liorknafo/plastic-shredder/cad/png/blade_variants.png

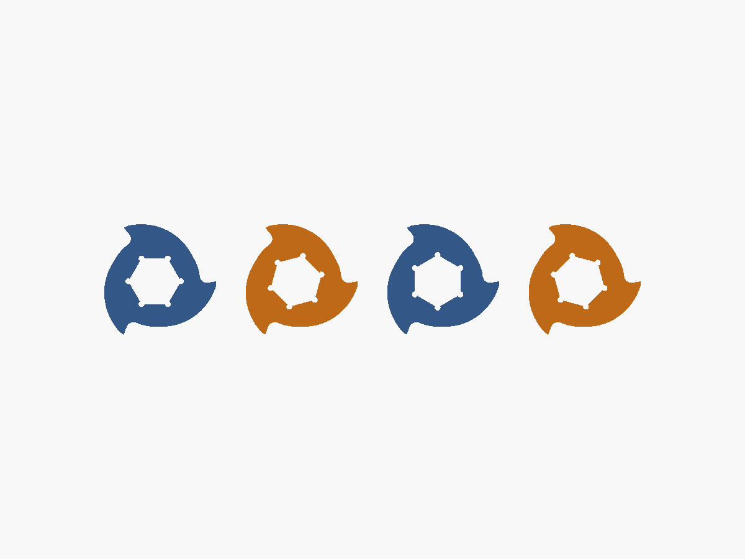
cad/png/blade_variants.png
