liorknafo/plastic-shredder/cad/png/comb_B.png

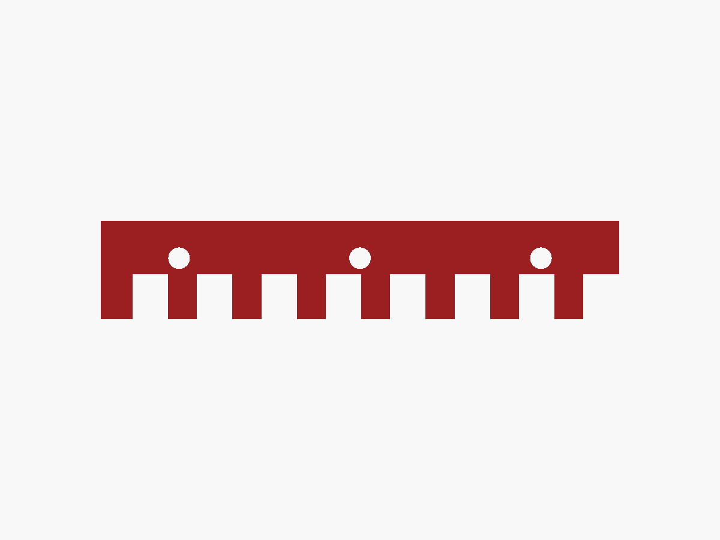
cad/png/comb_B.png
