liorknafo/plastic-shredder/cad/png/drive_tl.png

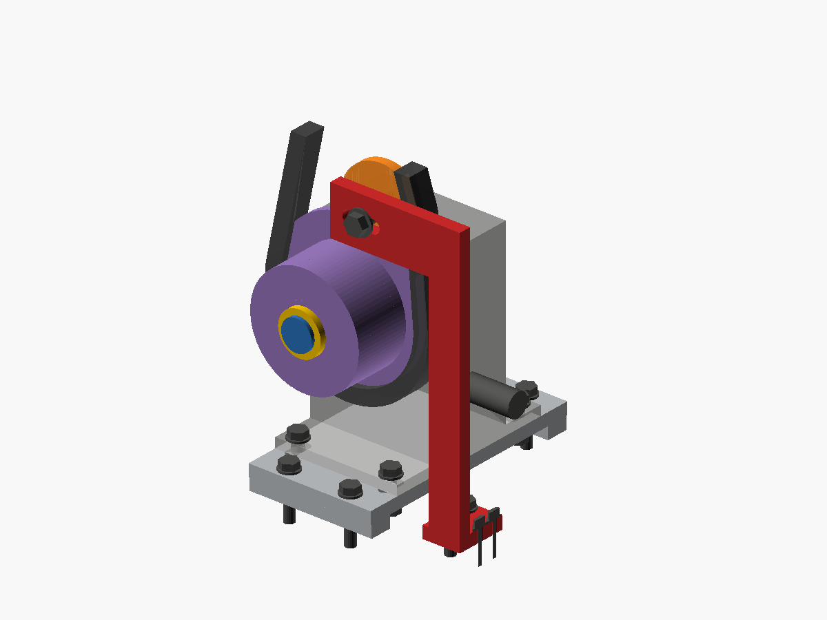
cad/png/drive_tl.png
