liorknafo/plastic-shredder/cad/png/drive_tl_section.png

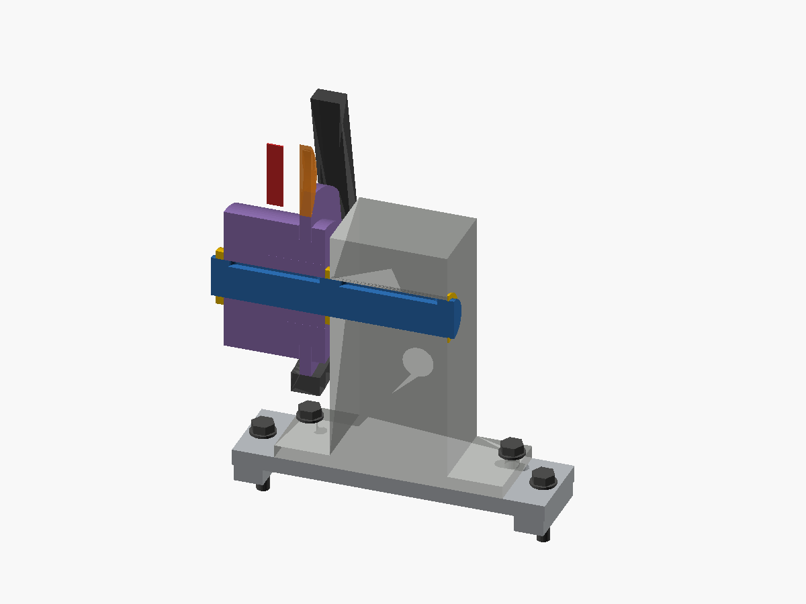
cad/png/drive_tl_section.png
