liorknafo/plastic-shredder/cad/png/gear_layer.png

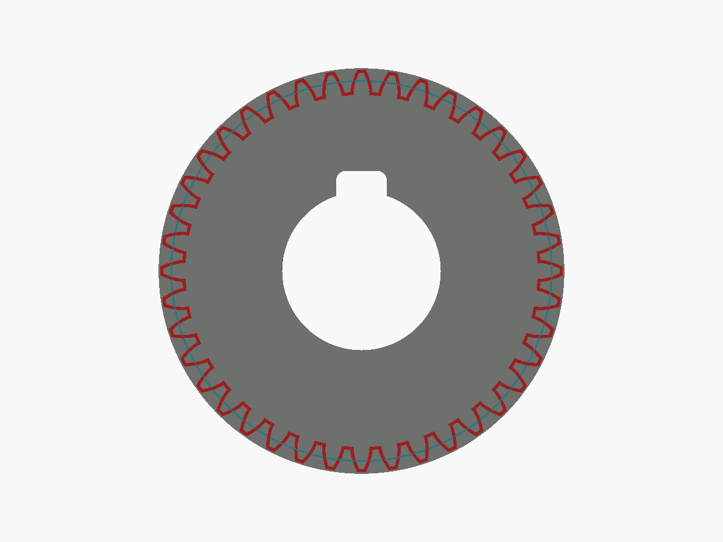
cad/png/gear_layer.png
