liorknafo/plastic-shredder/cad/png/gears_mesh.png

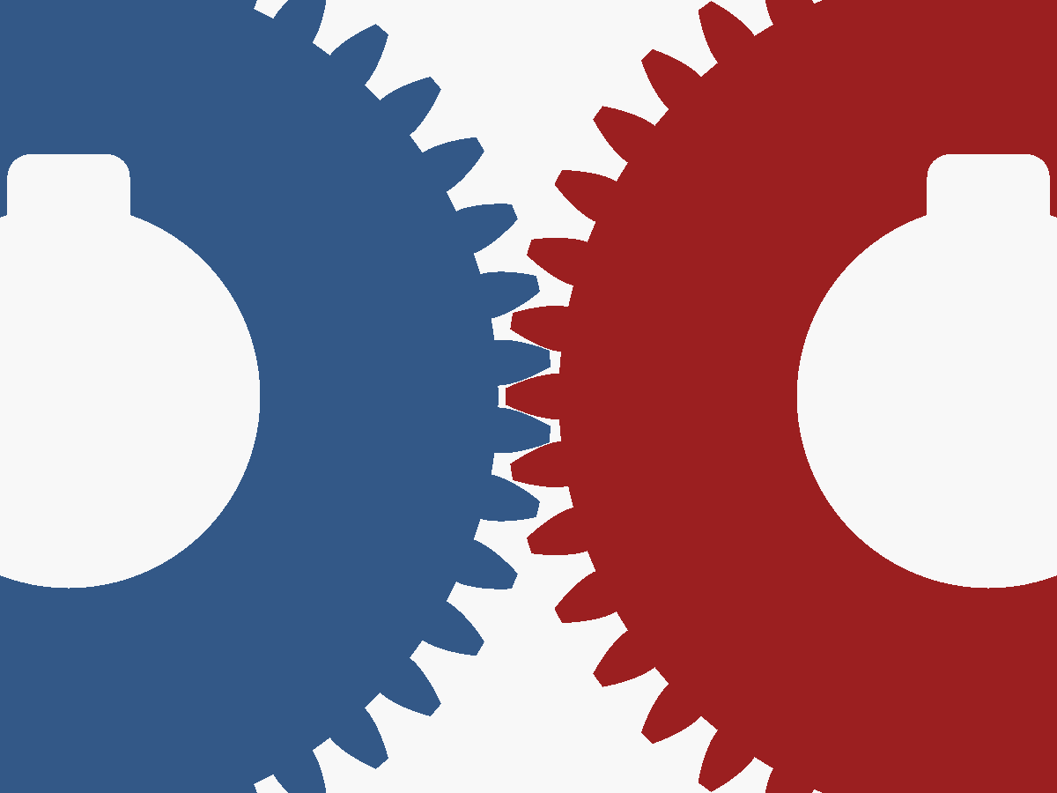
cad/png/gears_mesh.png
