liorknafo/plastic-shredder/cad/png/grid_section.png

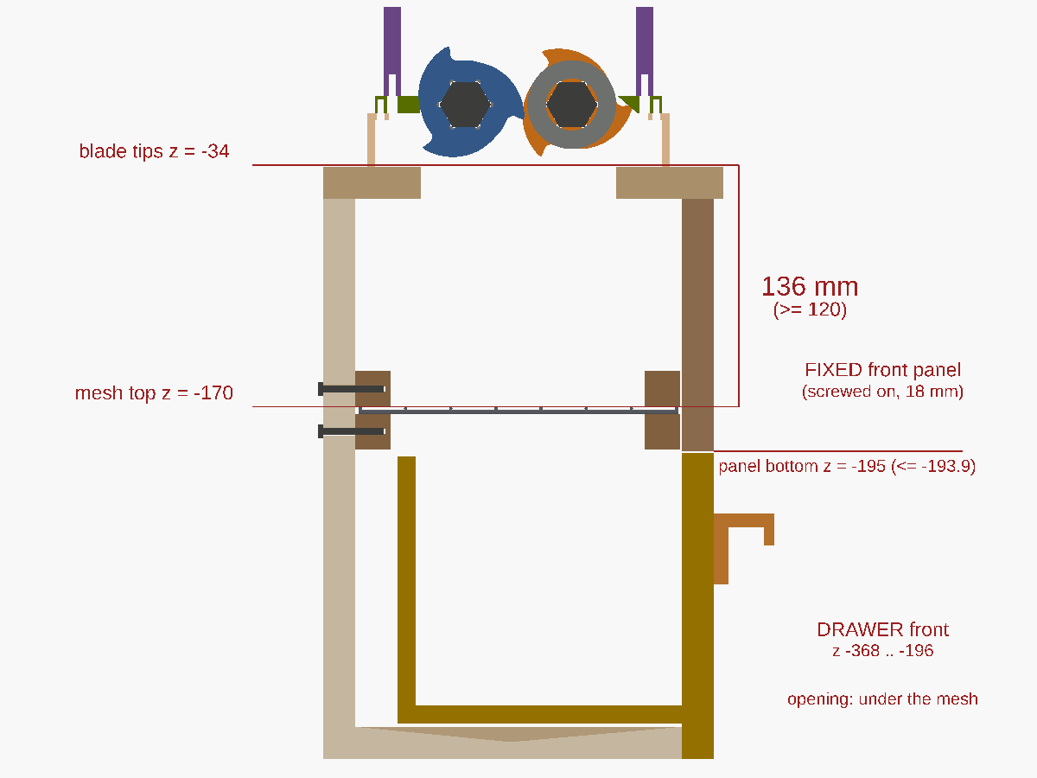
cad/png/grid_section.png
