liorknafo/plastic-shredder/cad/png/hopper_section.png

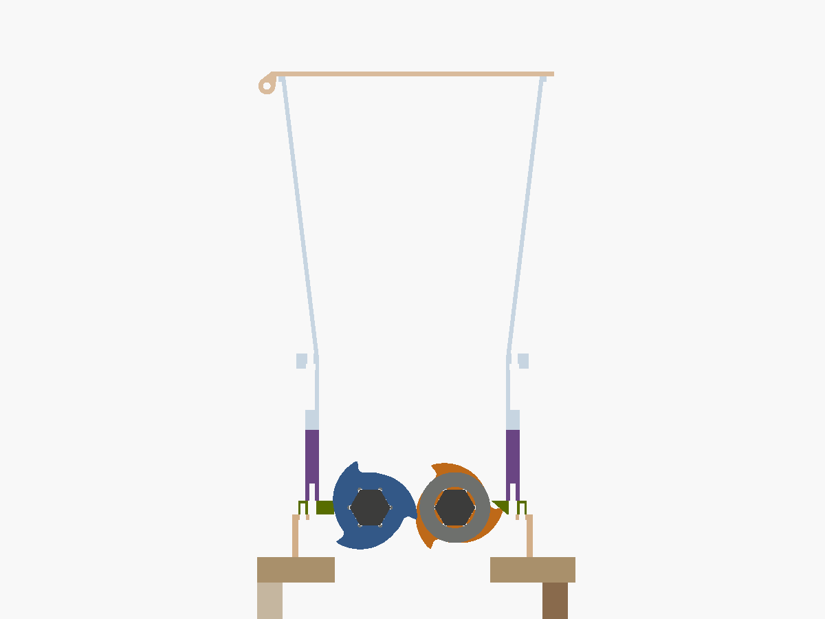
cad/png/hopper_section.png
