liorknafo/plastic-shredder/cad/png/interlock_drawer.png

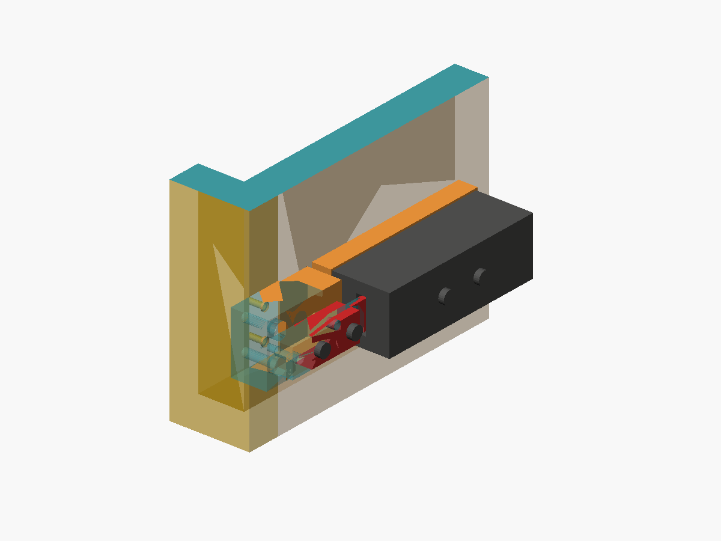
cad/png/interlock_drawer.png
