liorknafo/plastic-shredder/cad/png/interlock_hopper.png

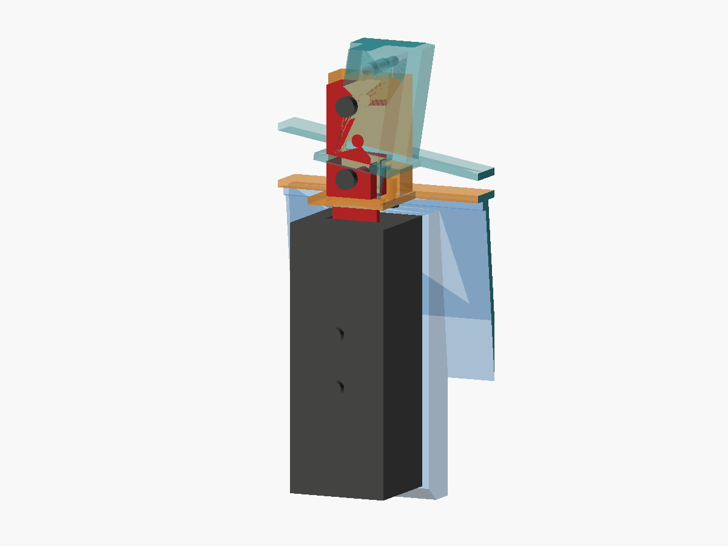
cad/png/interlock_hopper.png
