liorknafo/plastic-shredder/cad/png/plate_layers.png

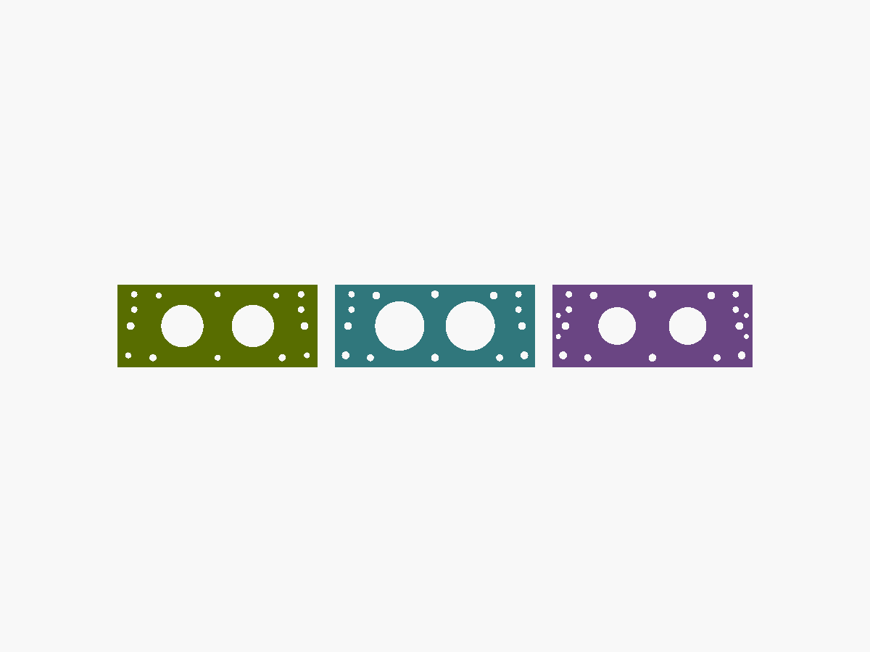
cad/png/plate_layers.png
