liorknafo/plastic-shredder/cad/png/section_x60.png

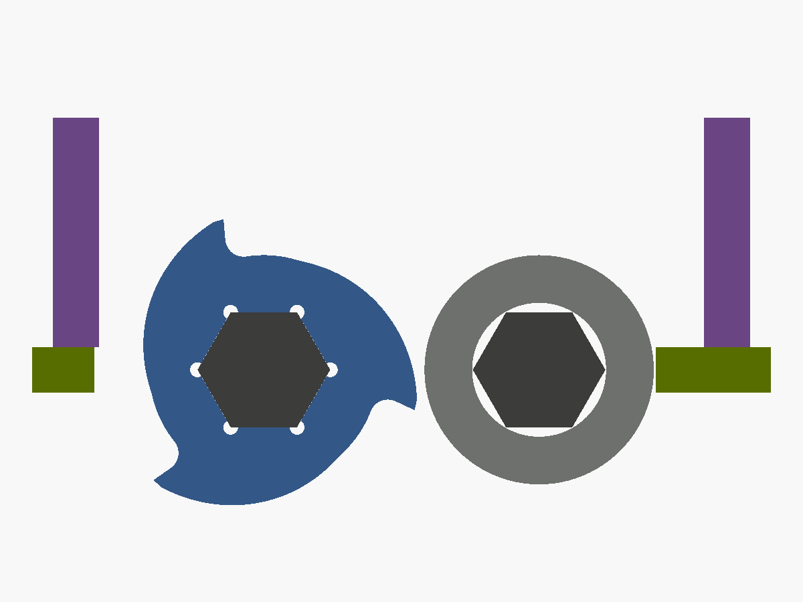
cad/png/section_x60.png
