liorknafo/plastic-shredder/cad/png/shaft_A.png

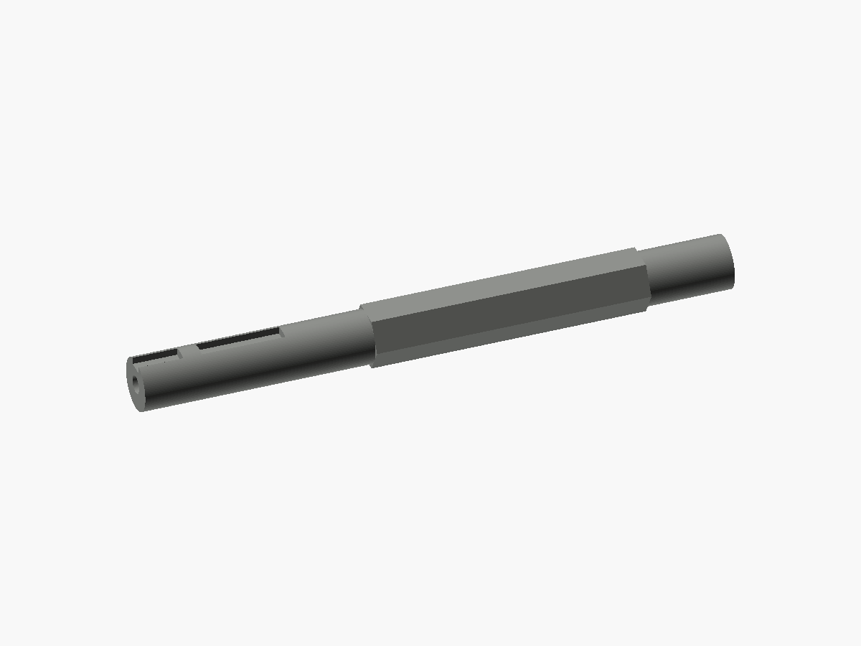
cad/png/shaft_A.png
