liorknafo/plastic-shredder/cad/png/solidcraft_drawer_180mm.png

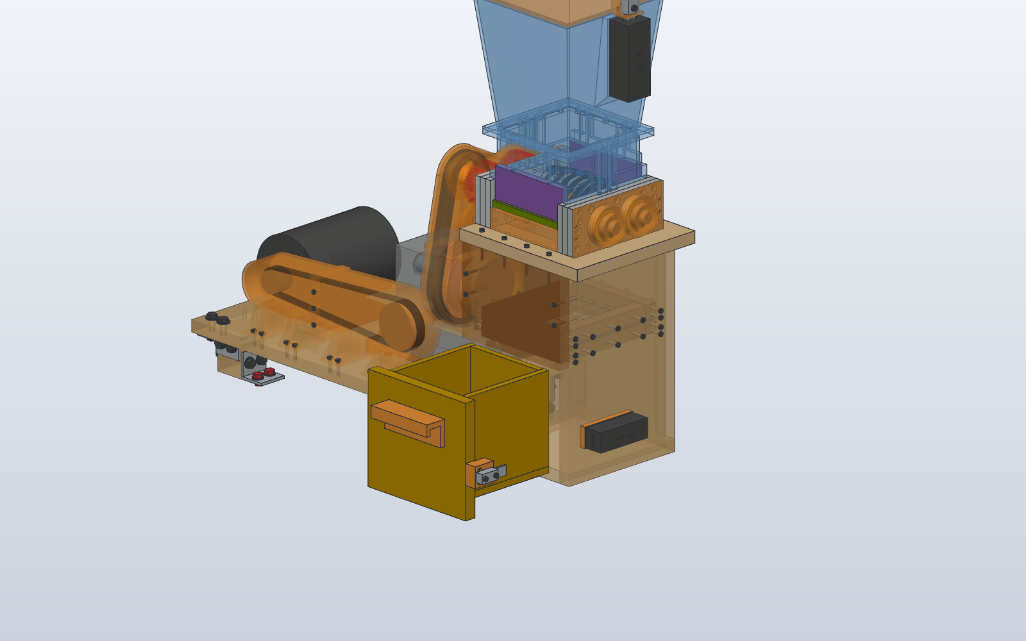
cad/png/solidcraft_drawer_180mm.png
