liorknafo/plastic-shredder/cad/png/solidcraft_lid_open_100deg.png

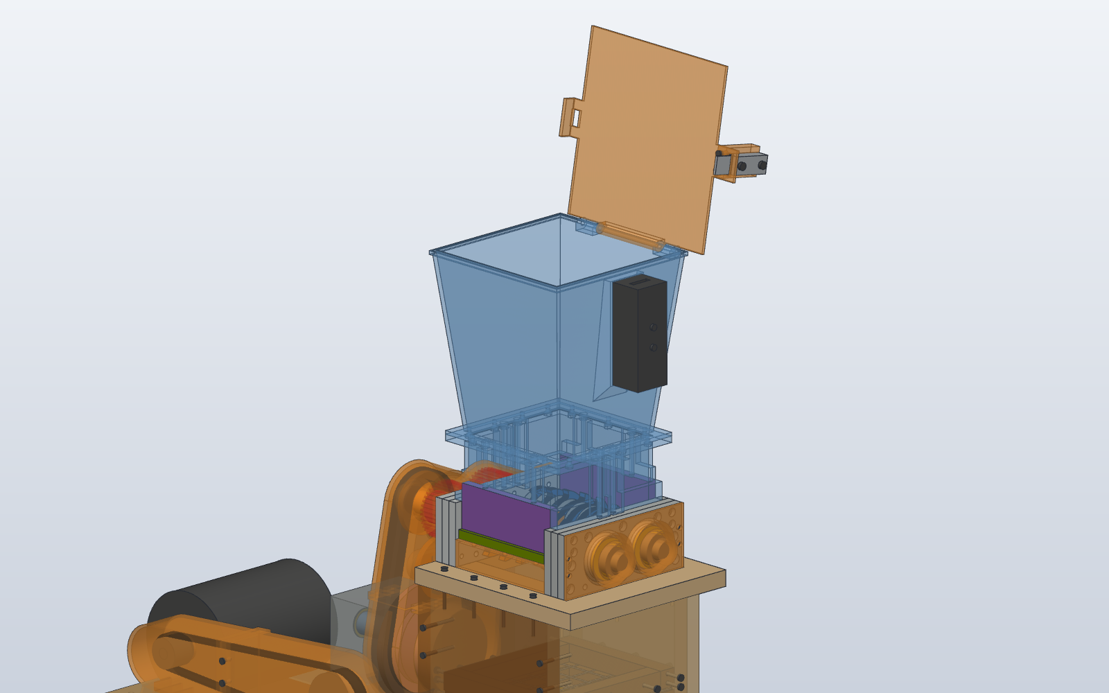
cad/png/solidcraft_lid_open_100deg.png
