liorknafo/plastic-shredder/cad/png/solidcraft_rotors_60deg.png

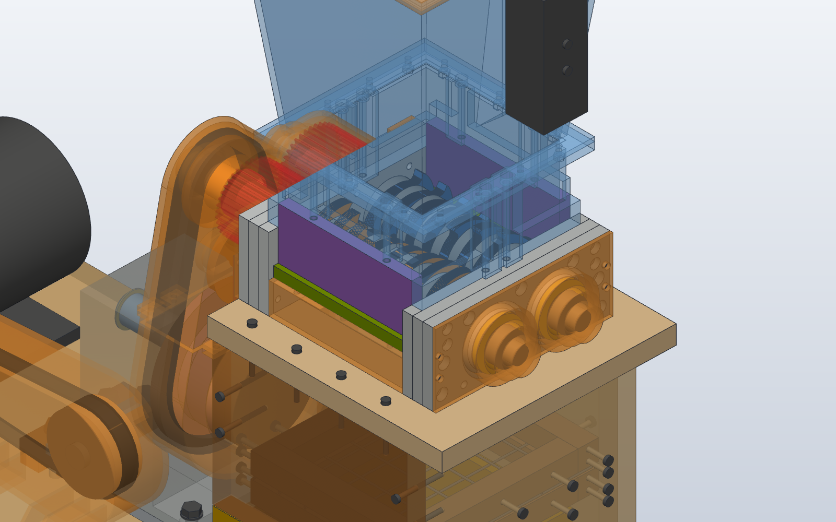
cad/png/solidcraft_rotors_60deg.png
