liorknafo/plastic-shredder/cad/png/solidcraft_section_blades.png

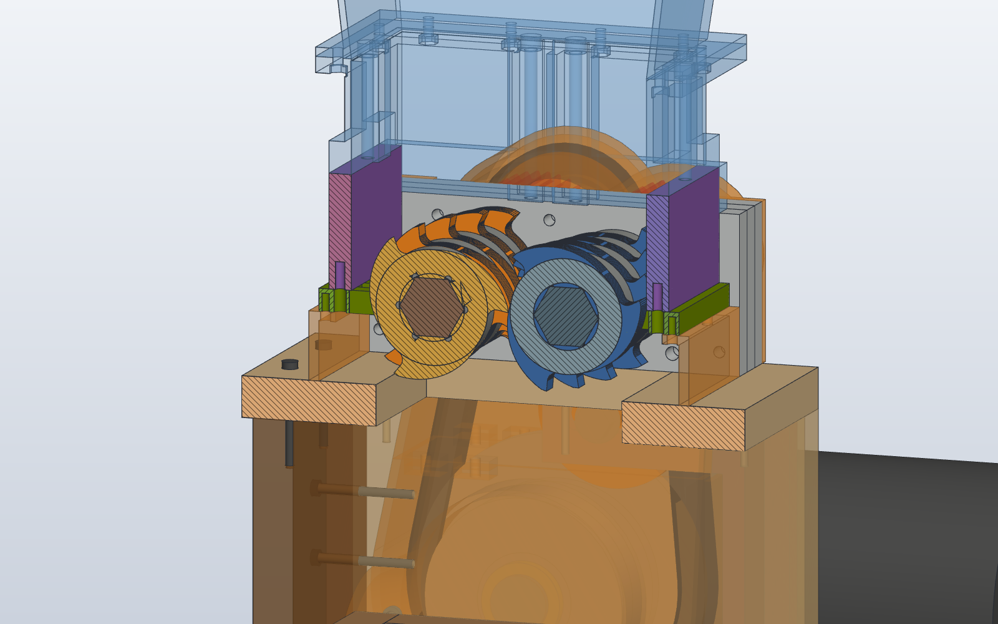
cad/png/solidcraft_section_blades.png
