liorknafo/plastic-shredder/cad/png/tl_setting.png

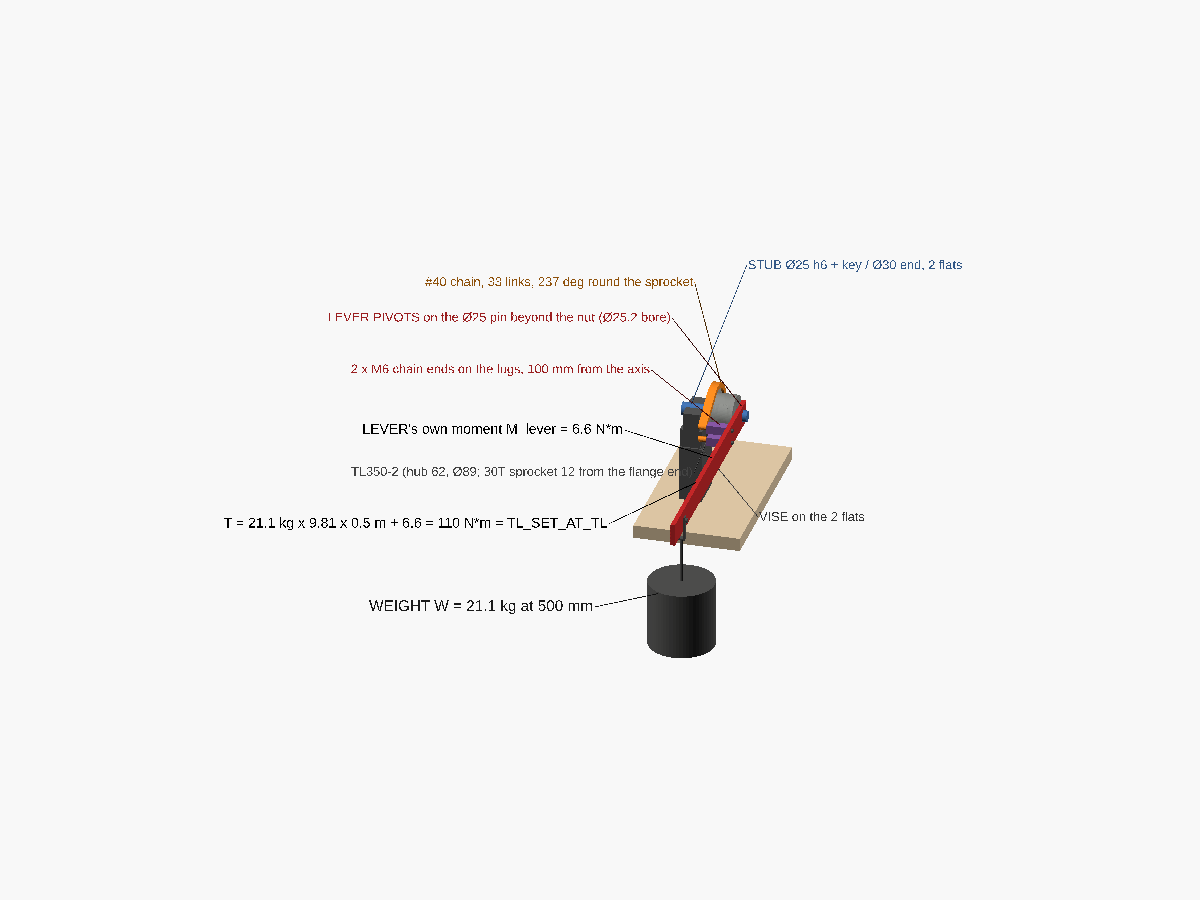
cad/png/tl_setting.png
