liorknafo/plastic-shredder/cad/shredder_assembly.3mf

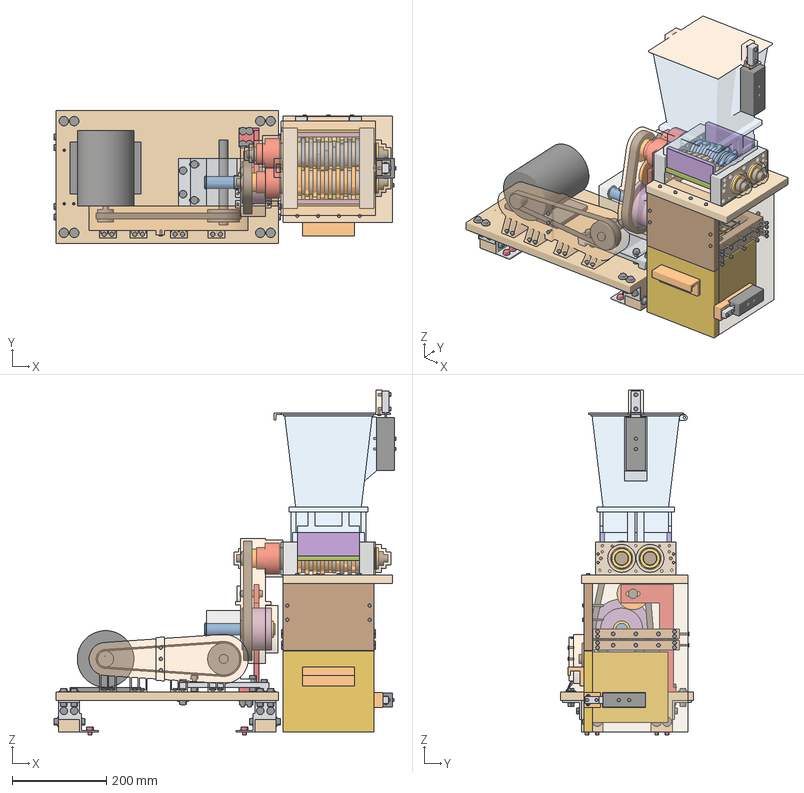
[picture p23: CAD file, 2026-11-12]
cad/shredder_assembly.3mf
724.2 x 282.7 x 730.5 mm
Shaft A
Shaft B
Blades A
Blades B
Spacers A
Spacers B
Clamp + collared sleeves A
Clamp + collared sleeves B
Gear A
Gear B
Sprocket 15T A
End screw (drive) A
End screw (drive) B
End screw (free) A
End screw (free) B
Needle bearings NA4905
Bearing rollers
Seals
Thrust bearings
Crinkle washers
End plates (free end)
End plates (drive end)
Combs
Chamber walls
Hopper collar + funnel
Hopper lid
Lid guard-lock switch (Pizzato)
Lid actuator key
Side skirts
Drive-end guard + free-end cover
Base plate
Cabinet (sides, back, floor)
FIXED upper front panel
Drawer (front + bin)
Drawer handle + switch pads
Drawer switch (Omron) + screws
Drawer switch key
Safety grid mesh
Grid cleats
Grid screws
Worm gearbox NRV063
Worm + gearbox bolts
Gearbox output shaft (4140)
Torque limiter TL350
Circlip, spacer, stop collar
Gearbox rails
Chain idler sprocket
Chain tensioner
Chain #40
Motor + pulleys
V-belt
Belt guard
Belt guard hardware
Drive deck + legs
Leg angles
Deck bolts
Floor anchors
