liorknafo/plastic-shredder/cad/dxf/cabinet_panels.dxf

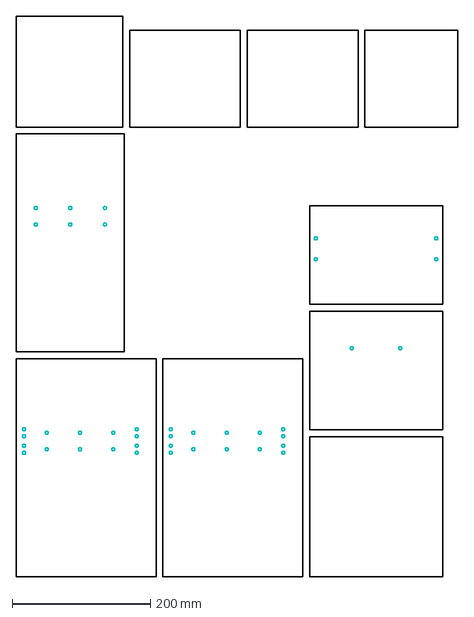
[picture p24: CAD file, 2026-11-12]
cad/dxf/cabinet_panels.dxf
638.0 x 810.0 mm
