liorknafo/plastic-shredder/cad/step/tens_upright.step

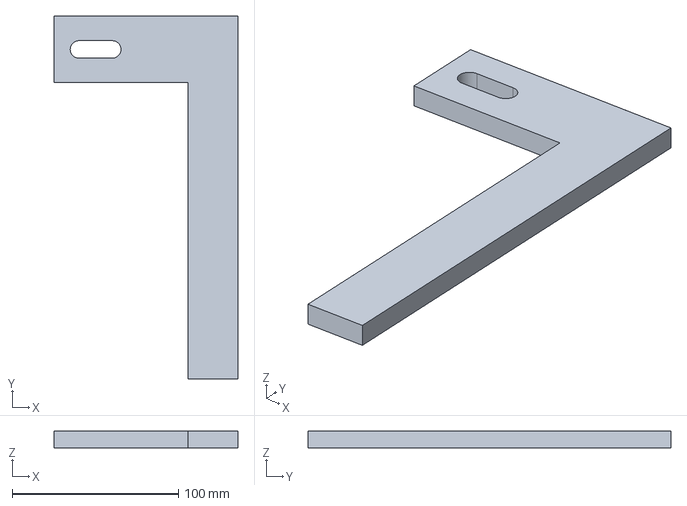
[picture p25: CAD file, 2026-11-12]
cad/step/tens_upright.step
110.6 x 218.0 x 10.0 mm
