liorknafo/plastic-shredder/cad/stl/stop_collar.stl

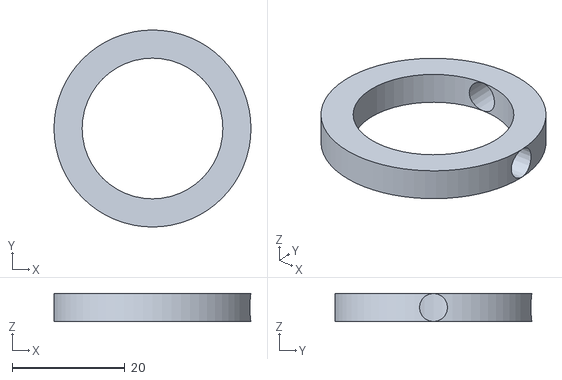
[picture p26: CAD file, 2026-11-12]
cad/stl/stop_collar.stl
35.0 x 35.0 x 5.00
