liorknafo/plastic-shredder/cad/dxf/gear_profile.dxf

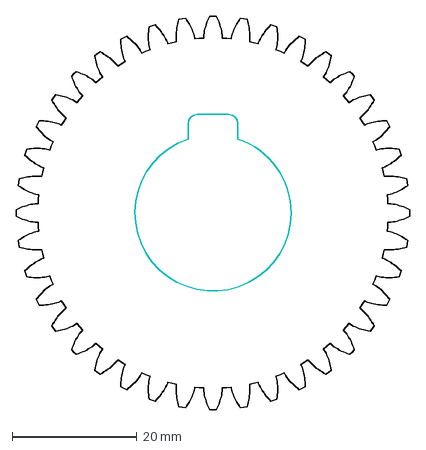
[picture p27: CAD file, 2026-11-12]
cad/dxf/gear_profile.dxf
63.0 x 63.0 mm
