liorknafo/plastic-shredder/cad/step/comb_A.step

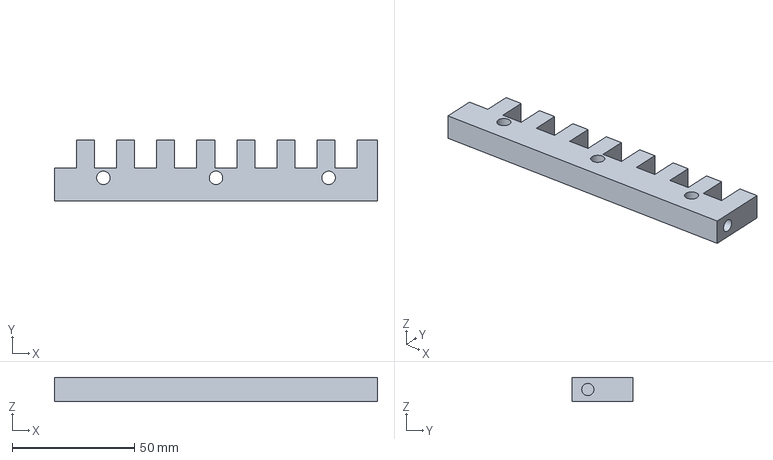
[picture p28: CAD file, 2026-11-12]
cad/step/comb_A.step
132.2 x 25.0 x 10.0 mm
