liorknafo/plastic-shredder/cad/step/sleeve_free_A.step

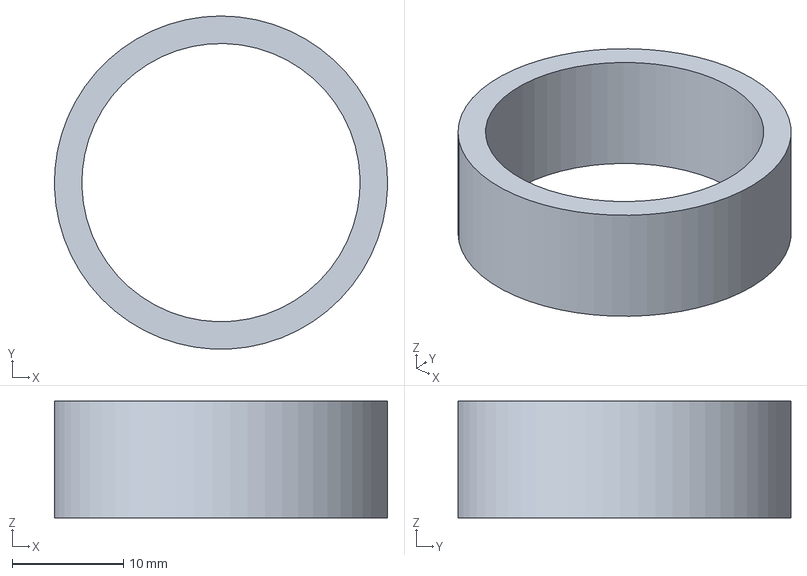
[picture p29: CAD file, 2026-11-12]
cad/step/sleeve_free_A.step
30.0 x 30.0 x 10.5 mm
