liorknafo/plastic-shredder/cad/step/grid_mesh.step

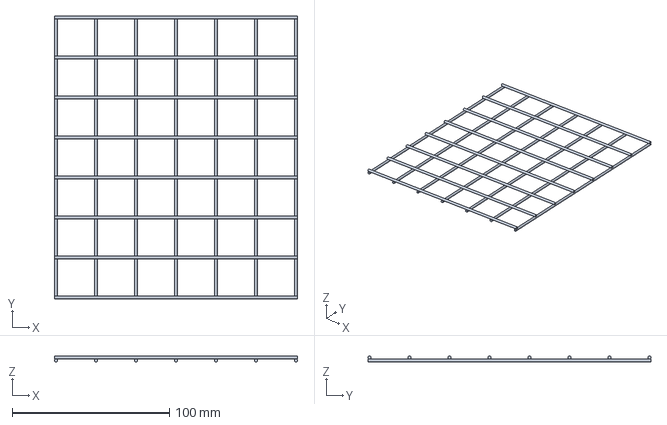
[picture p30: CAD file, 2026-11-12]
cad/step/grid_mesh.step
154.4 x 179.8 x 3.90 mm
