liorknafo/plastic-shredder/cad/step/hopper_lid.step

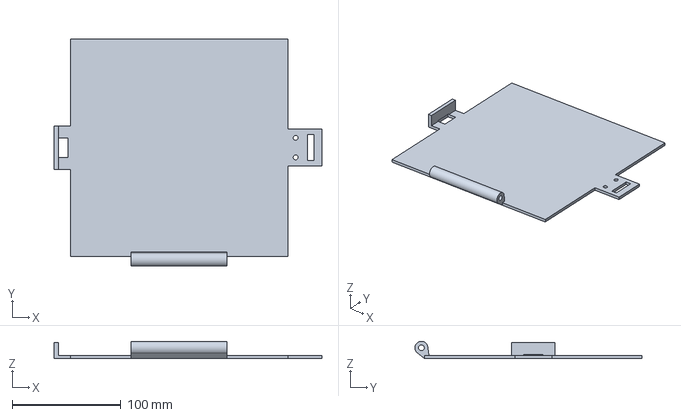
[picture p31: CAD file, 2026-11-12]
cad/step/hopper_lid.step
246.5 x 209.0 x 16.0 mm
