liorknafo/plastic-shredder/cad/step/hopper_collar.step

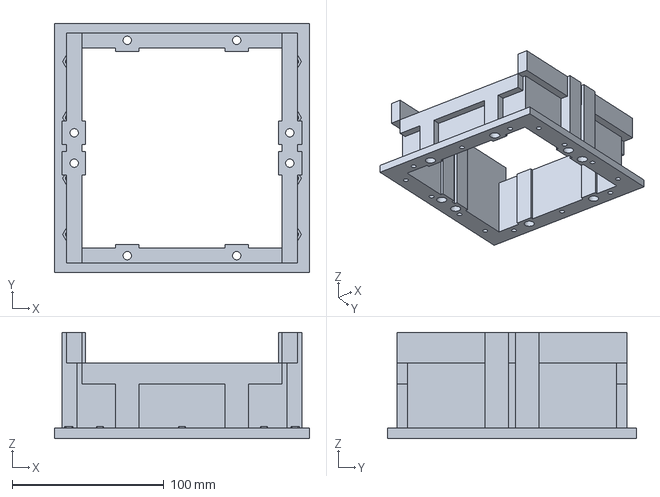
[picture p32: CAD file, 2026-11-12]
cad/step/hopper_collar.step
168.2 x 164.0 x 70.0 mm
