liorknafo/plastic-shredder/cad/step/skirt_A.step

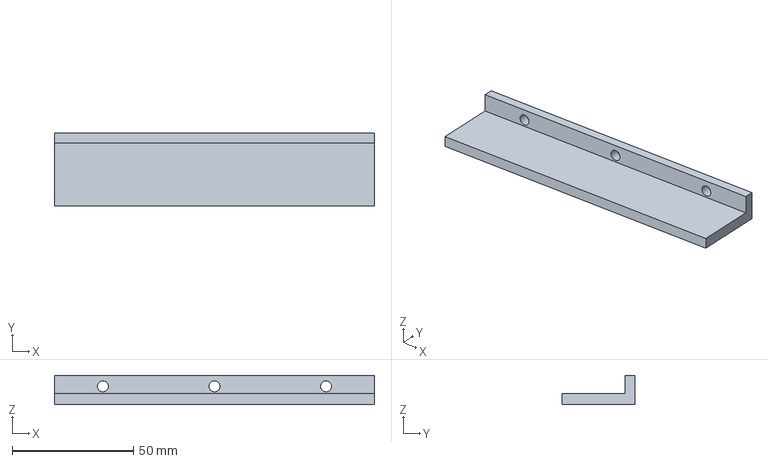
[picture p33: CAD file, 2026-11-12]
cad/step/skirt_A.step
132.2 x 30.0 x 12.0 mm
