liorknafo/plastic-shredder/cad/step/tl_lug.step

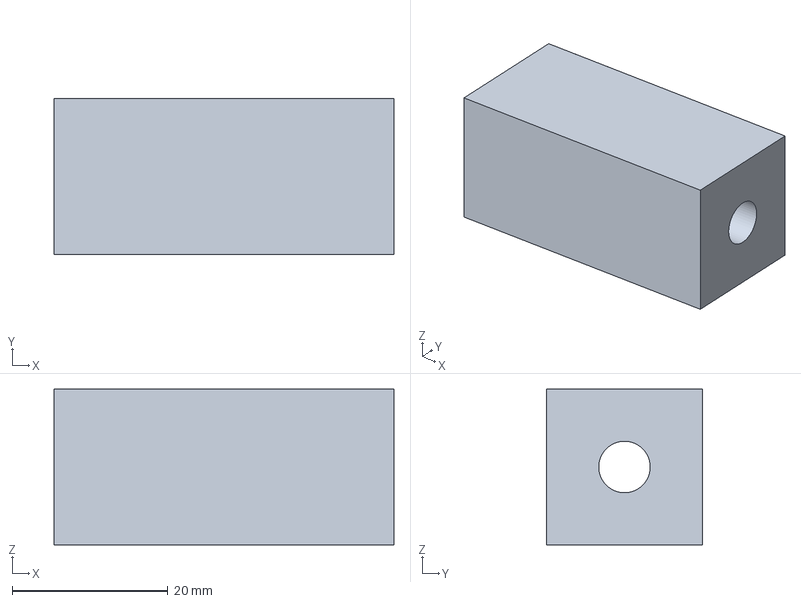
[picture p34: CAD file, 2026-11-12]
cad/step/tl_lug.step
43.6 x 20.0 x 20.0 mm
