liorknafo/plastic-shredder/cad/step/gear_B.step

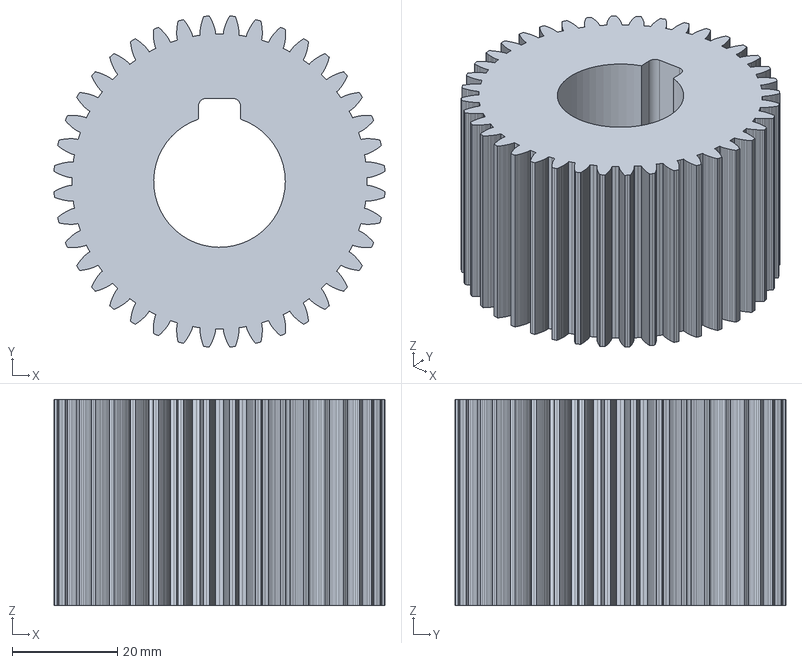
[picture p35: CAD file, 2026-11-12]
cad/step/gear_B.step
62.9 x 62.9 x 39.2 mm
