liorknafo/plastic-shredder/cad/step/end_cap.step

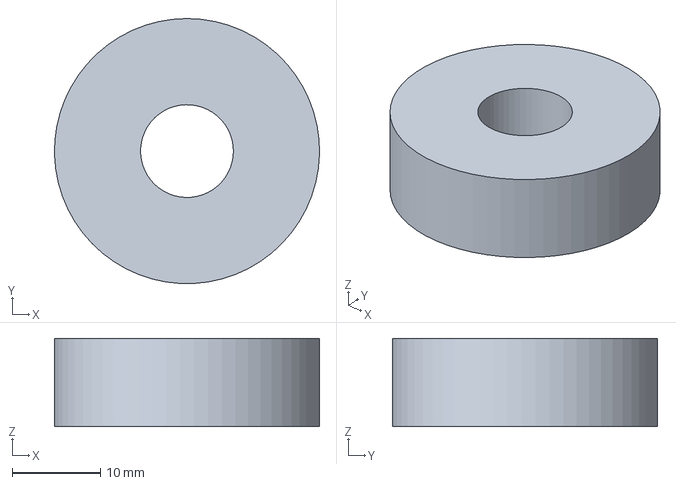
[picture p36: CAD file, 2026-11-12]
cad/step/end_cap.step
30.0 x 30.0 x 10.0 mm
