liorknafo/plastic-shredder/cad/step/wall.step

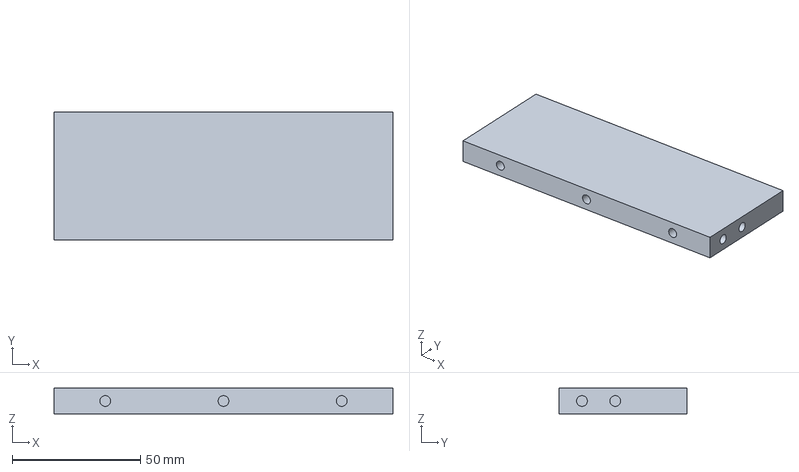
[picture p37: CAD file, 2026-11-12]
cad/step/wall.step
132.2 x 50.0 x 10.0 mm
