liorknafo/plastic-shredder/cad/step/drawer_act_pad.step

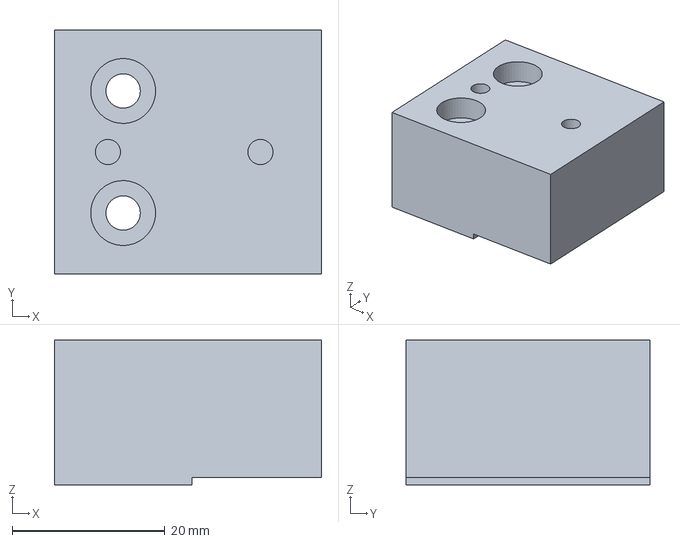
[picture p38: CAD file, 2026-11-12]
cad/step/drawer_act_pad.step
35.0 x 32.0 x 19.0 mm
