liorknafo/plastic-shredder/cad/step/sleeve_free_B.step

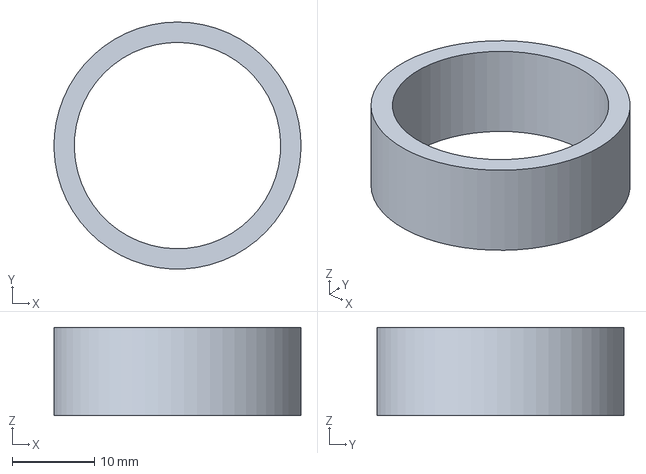
[picture p39: CAD file, 2026-11-12]
cad/step/sleeve_free_B.step
30.0 x 30.0 x 10.7 mm
