liorknafo/plastic-shredder/cad/step/output_shaft.step

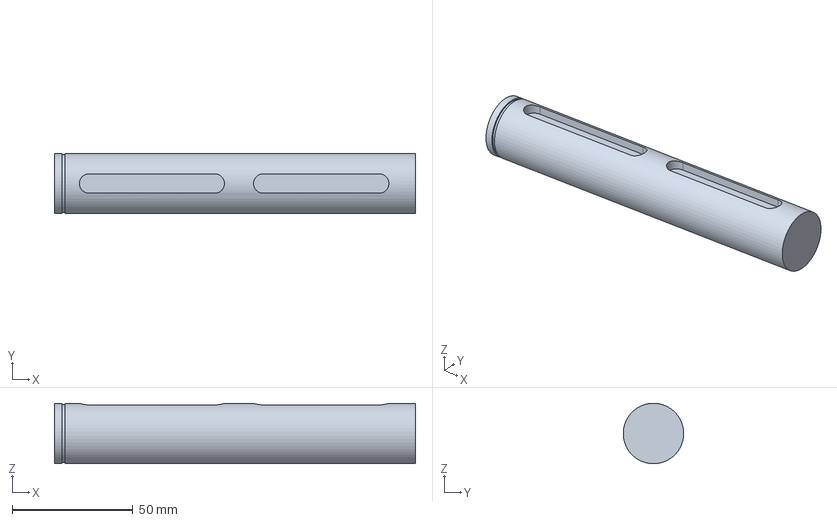
[picture p40: CAD file, 2026-11-12]
cad/step/output_shaft.step
149.3 x 25.0 x 25.0 mm
