liorknafo/plastic-shredder/cad/step/belt_guard_b.step

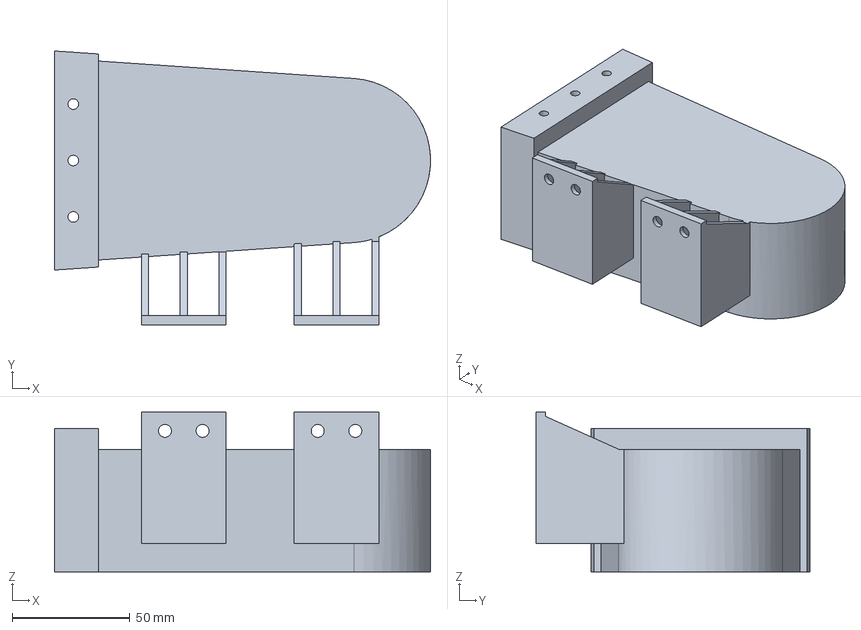
[picture p41: CAD file, 2026-11-12]
cad/step/belt_guard_b.step
160.0 x 116.6 x 68.0 mm
