liorknafo/plastic-shredder/cad/step/belt_guard_a.step

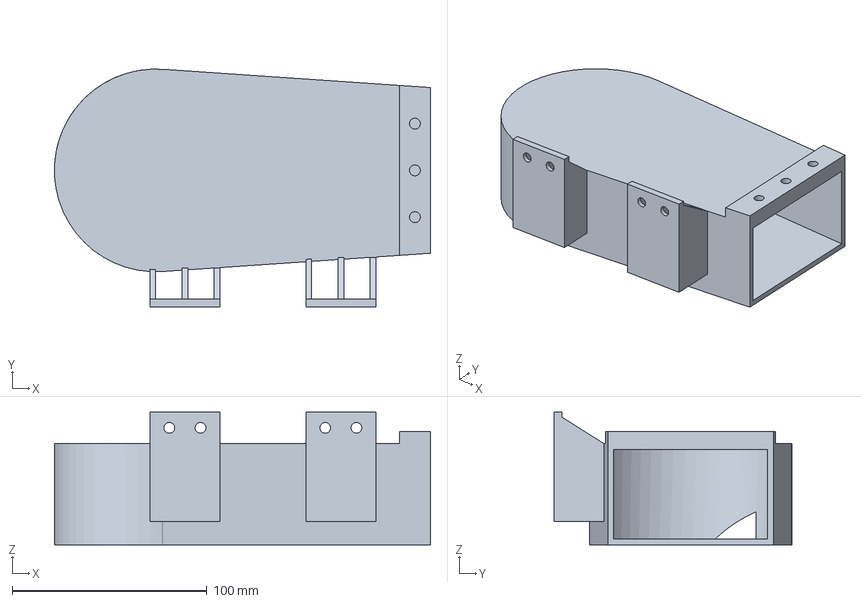
[picture p42: CAD file, 2026-11-12]
cad/step/belt_guard_a.step
192.9 x 121.9 x 68.0 mm
