liorknafo/plastic-shredder/cad/step/collar_sleeve_drive.step

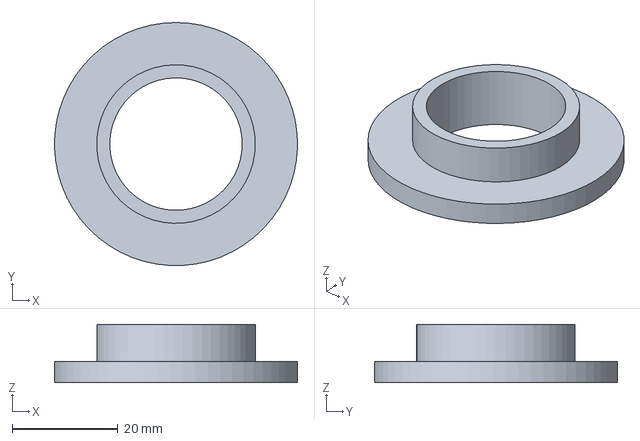
[picture p43: CAD file, 2026-11-12]
cad/step/collar_sleeve_drive.step
46.0 x 46.0 x 11.0 mm
