liorknafo/plastic-shredder/cad/step/gb_rail.step

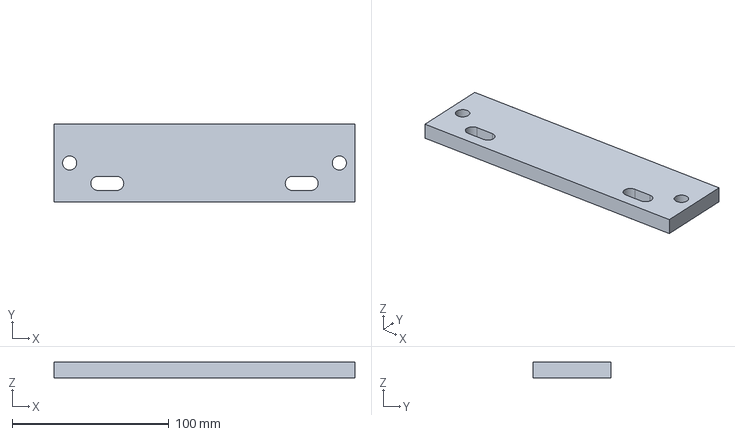
[picture p44: CAD file, 2026-11-12]
cad/step/gb_rail.step
192.0 x 50.0 x 10.0 mm
