liorknafo/plastic-shredder/cad/step/plate_cap.step

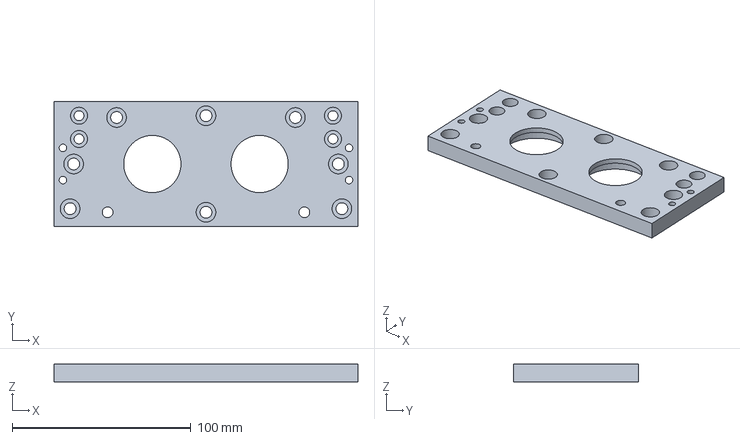
[picture p45: CAD file, 2026-11-12]
cad/step/plate_cap.step
170.0 x 70.0 x 10.0 mm
