liorknafo/plastic-shredder/cad/step/drawer_handle.step

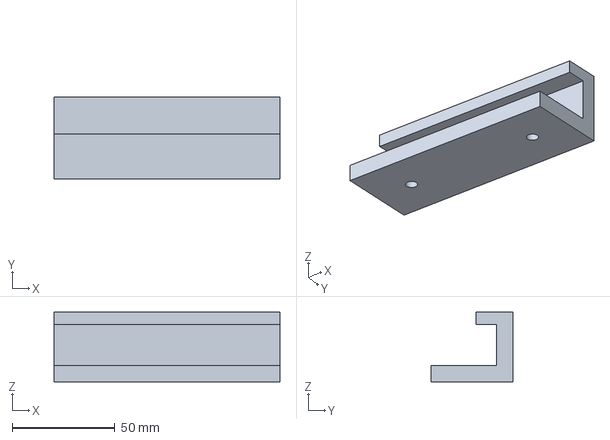
[picture p47: CAD file, 2026-11-12]
cad/step/drawer_handle.step
110.0 x 40.0 x 34.0 mm
