liorknafo/plastic-shredder/cad/step/drive_deck.step

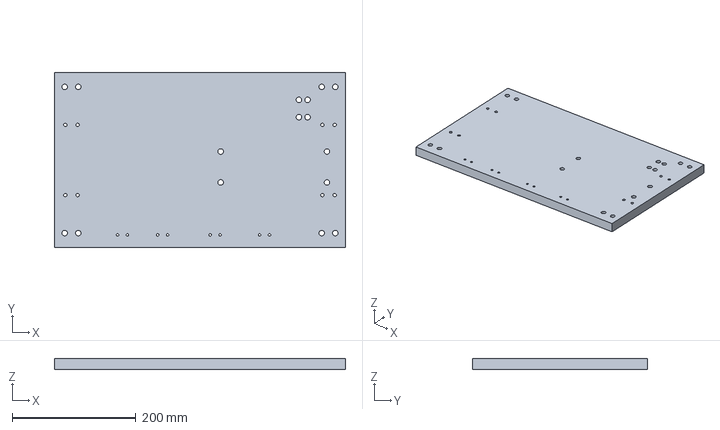
[picture p48: CAD file, 2026-11-12]
cad/step/drive_deck.step
471.0 x 282.7 x 18.0 mm
