liorknafo/plastic-shredder/cad/step/hopper_lid_pad.step

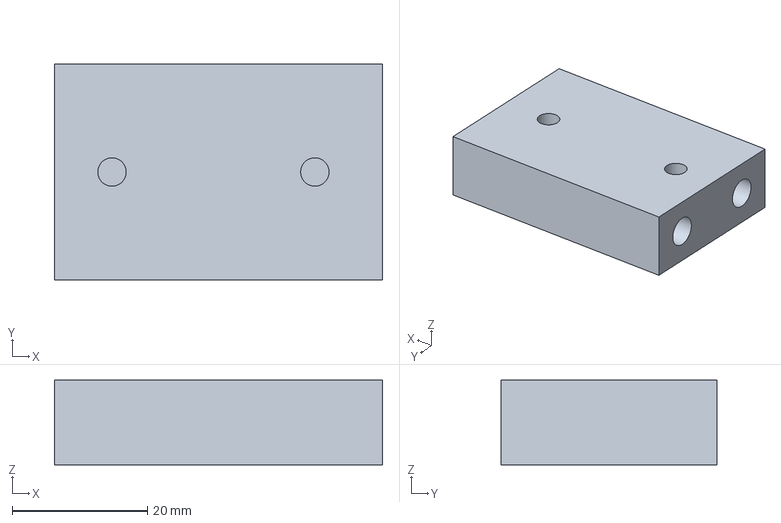
[picture p49: CAD file, 2026-11-12]
cad/step/hopper_lid_pad.step
48.5 x 32.0 x 12.5 mm
