liorknafo/plastic-shredder/cad/step/blade_v3.step

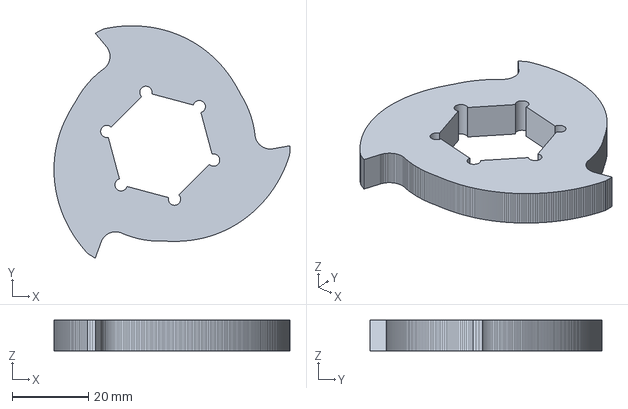
[picture p50: CAD file, 2026-11-12]
cad/step/blade_v3.step
61.8 x 60.9 x 8.00 mm
