liorknafo/plastic-shredder/cad/step/gb_spacer.step

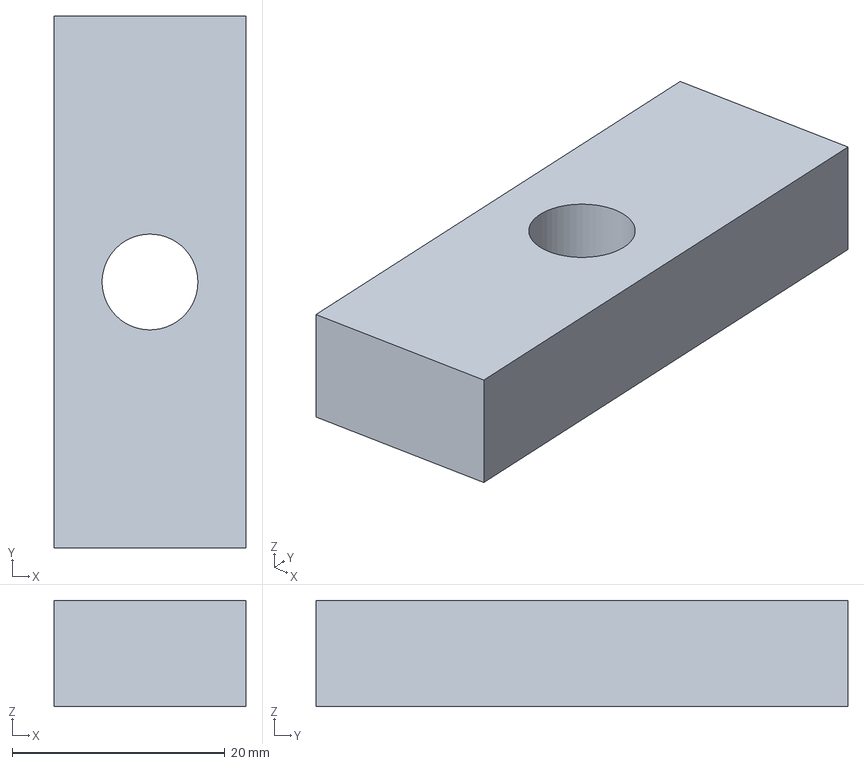
[picture p51: CAD file, 2026-11-12]
cad/step/gb_spacer.step
18.0 x 50.0 x 10.0 mm
