liorknafo/plastic-shredder/cad/step/tl_stub.step

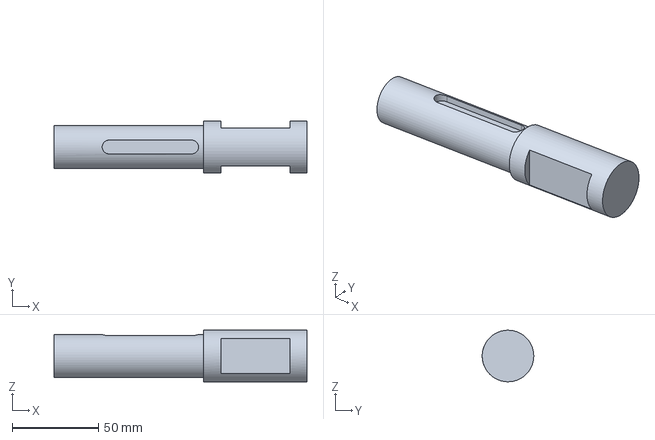
[picture p52: CAD file, 2026-11-12]
cad/step/tl_stub.step
147.0 x 30.0 x 30.0 mm
