liorknafo/plastic-shredder/cad/step/shaft_A.step

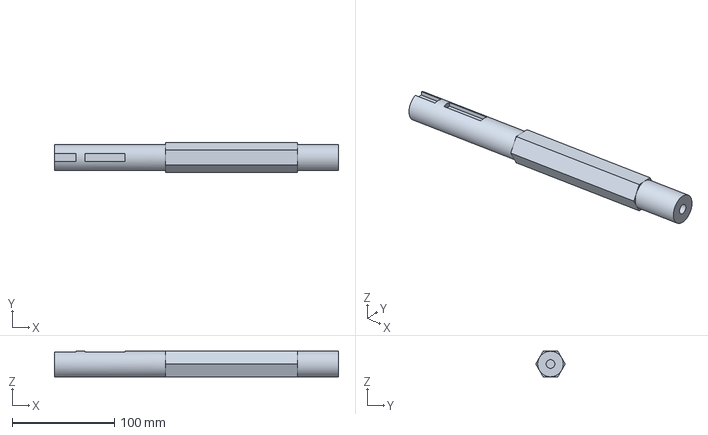
[picture p53: CAD file, 2026-11-12]
cad/step/shaft_A.step
277.6 x 28.9 x 25.1 mm
