liorknafo/plastic-shredder/cad/step/tl_lever.step

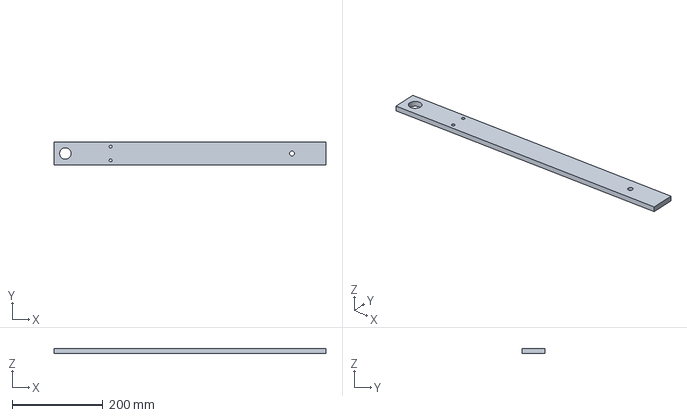
[picture p54: CAD file, 2026-11-12]
cad/step/tl_lever.step
600.0 x 50.0 x 10.0 mm
