liorknafo/plastic-shredder/cad/step/gear_spacer.step

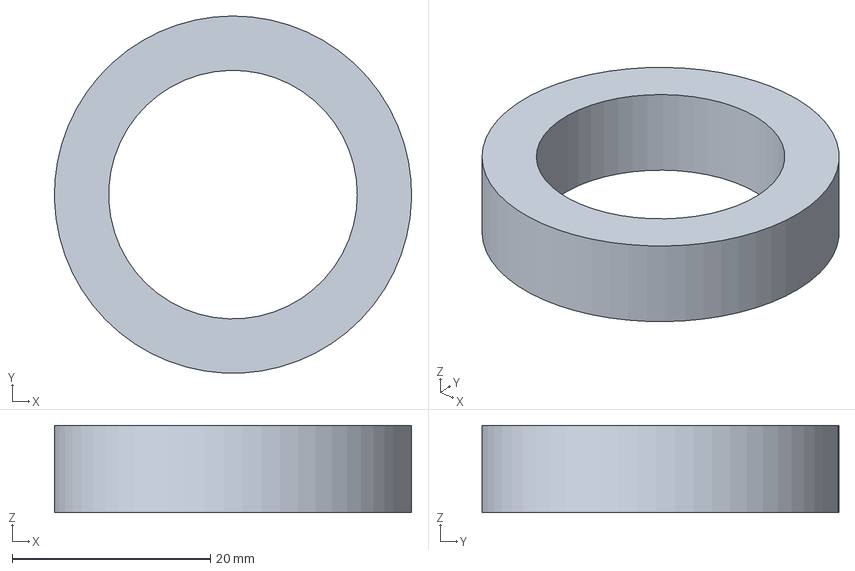
[picture p55: CAD file, 2026-11-12]
cad/step/gear_spacer.step
36.0 x 36.0 x 8.80 mm
