liorknafo/plastic-shredder/cad/step/drawer_pad.step

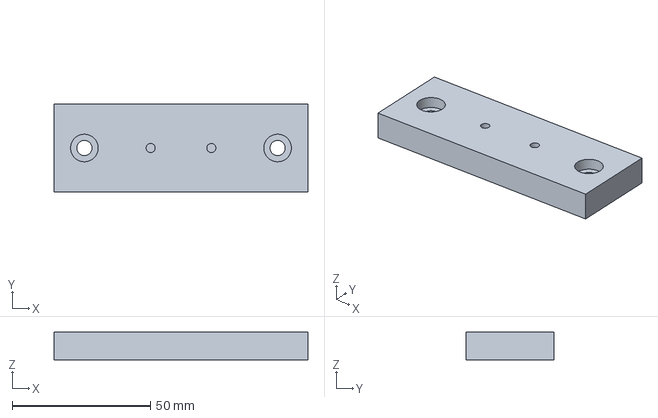
[picture p56: CAD file, 2026-11-12]
cad/step/drawer_pad.step
92.0 x 32.0 x 10.0 mm
