liorknafo/plastic-shredder/cad/step/hopper_funnel.step

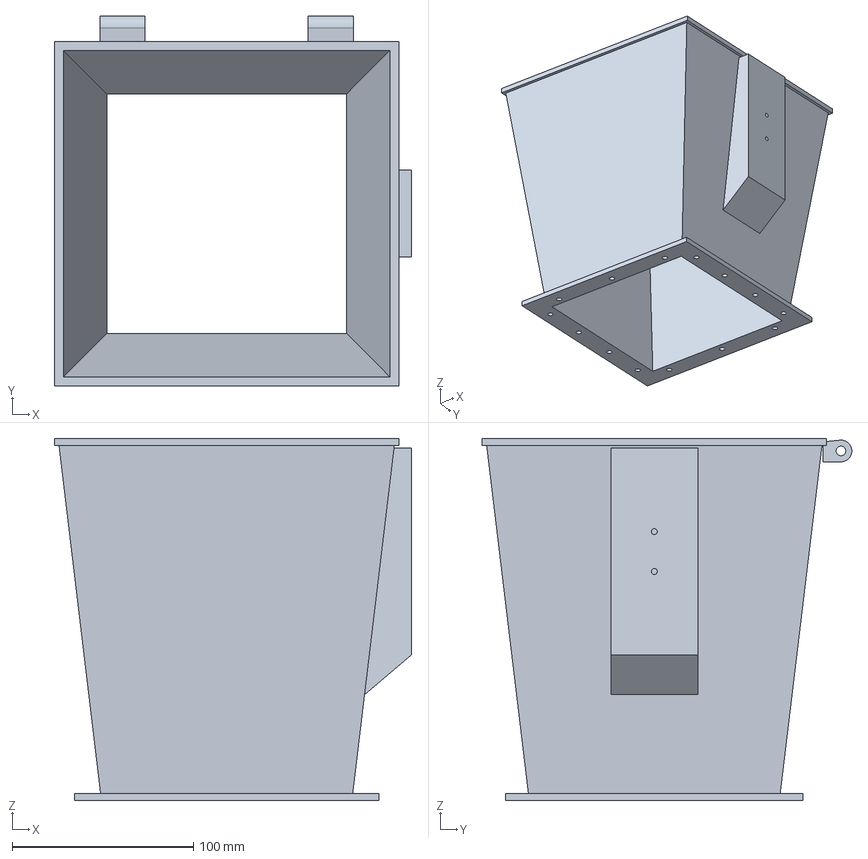
[picture p57: CAD file, 2026-11-12]
cad/step/hopper_funnel.step
197.0 x 204.0 x 200.0 mm
