liorknafo/plastic-shredder/cad/step/upper_front.step

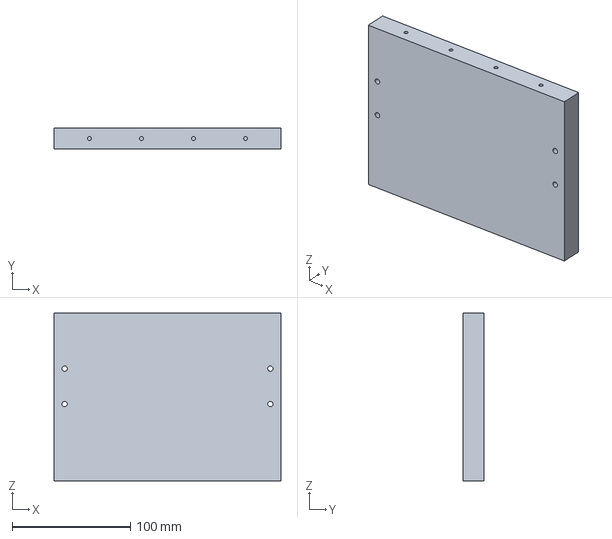
[picture p59: CAD file, 2026-11-12]
cad/step/upper_front.step
192.2 x 18.0 x 142.0 mm
