liorknafo/plastic-shredder/cad/step/cabinet.step

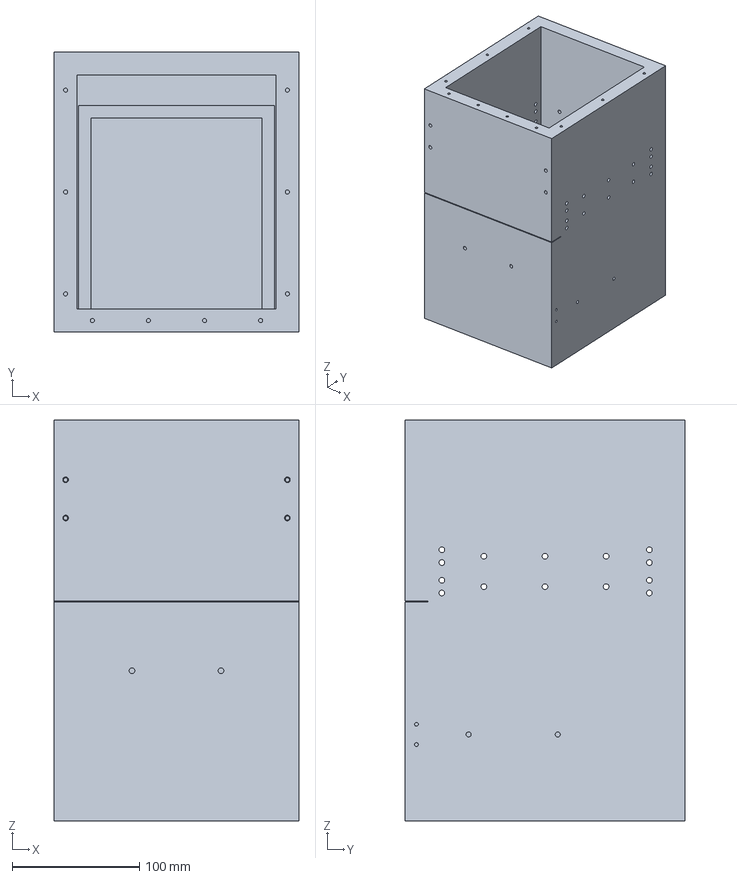
[picture p60: CAD file, 2026-11-12]
cad/step/cabinet.step
192.2 x 220.0 x 315.0 mm
