liorknafo/plastic-shredder/cad/step/end_spacer_B.step

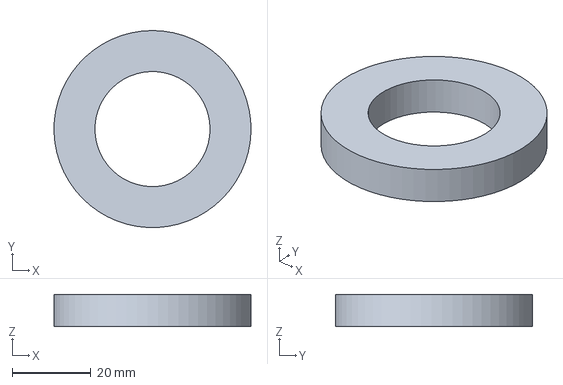
[picture p61: CAD file, 2026-11-12]
cad/step/end_spacer_B.step
50.0 x 50.0 x 8.20 mm
