liorknafo/plastic-shredder/cad/step/grid_cleats.step

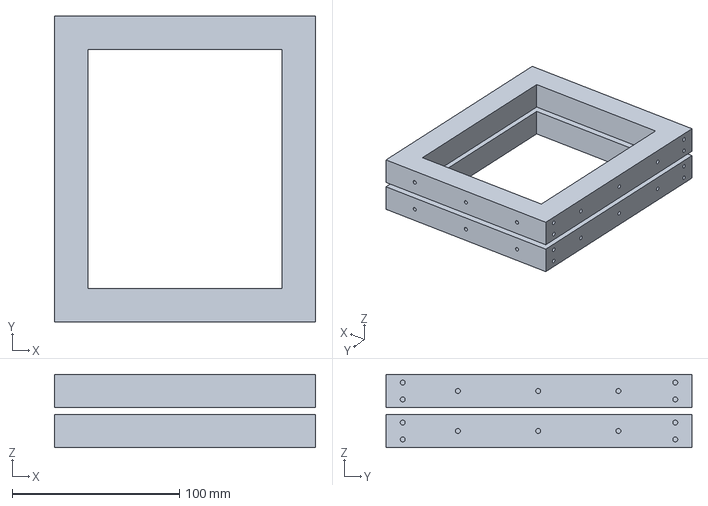
[picture p62: CAD file, 2026-11-12]
cad/step/grid_cleats.step
156.2 x 183.0 x 43.9 mm
