liorknafo/plastic-shredder/cad/step/dg_upper.step

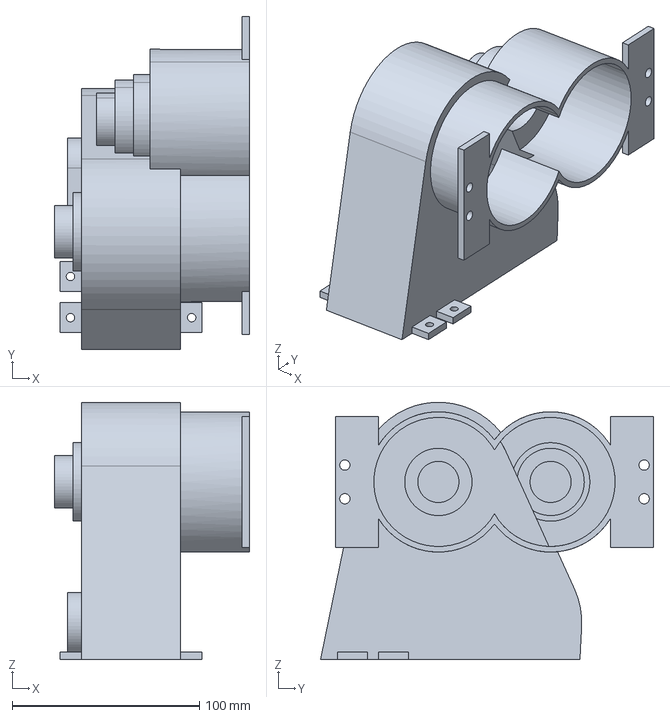
[picture p63: CAD file, 2026-11-12]
cad/step/dg_upper.step
104.4 x 178.0 x 137.5 mm
