liorknafo/plastic-shredder/cad/step/collar_sleeve_free.step

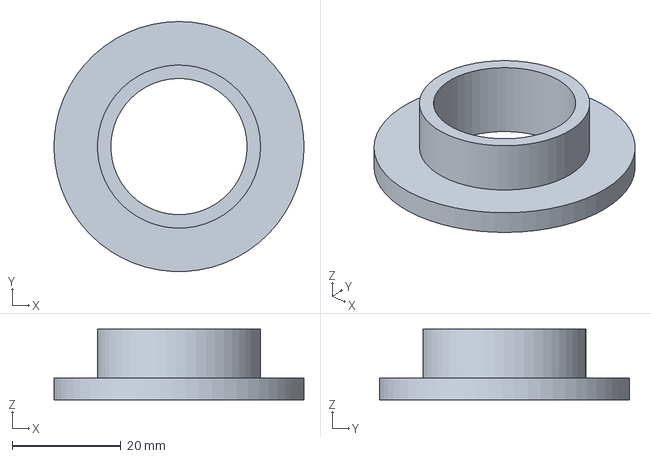
[picture p64: CAD file, 2026-11-12]
cad/step/collar_sleeve_free.step
46.0 x 46.0 x 13.0 mm
