liorknafo/plastic-shredder/cad/step/gear_layer.step

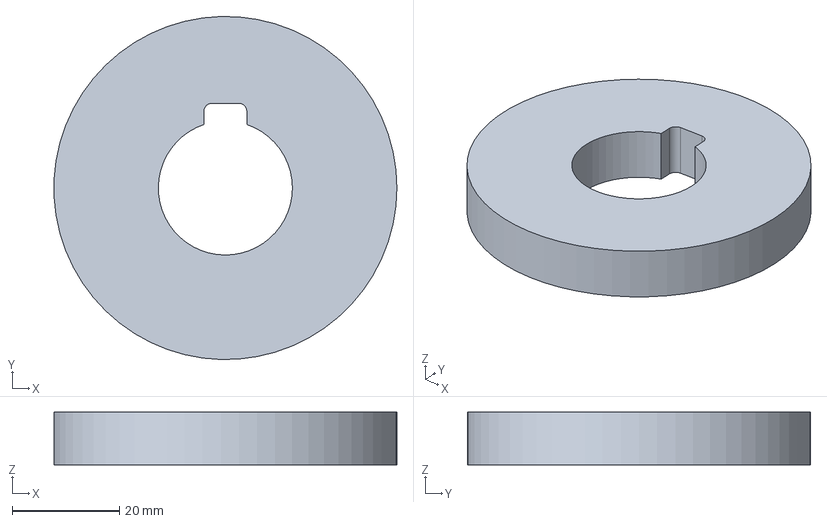
[picture p65: CAD file, 2026-11-12]
cad/step/gear_layer.step
64.0 x 64.0 x 9.80 mm
