liorknafo/plastic-shredder/cad/step/dg_lower.step

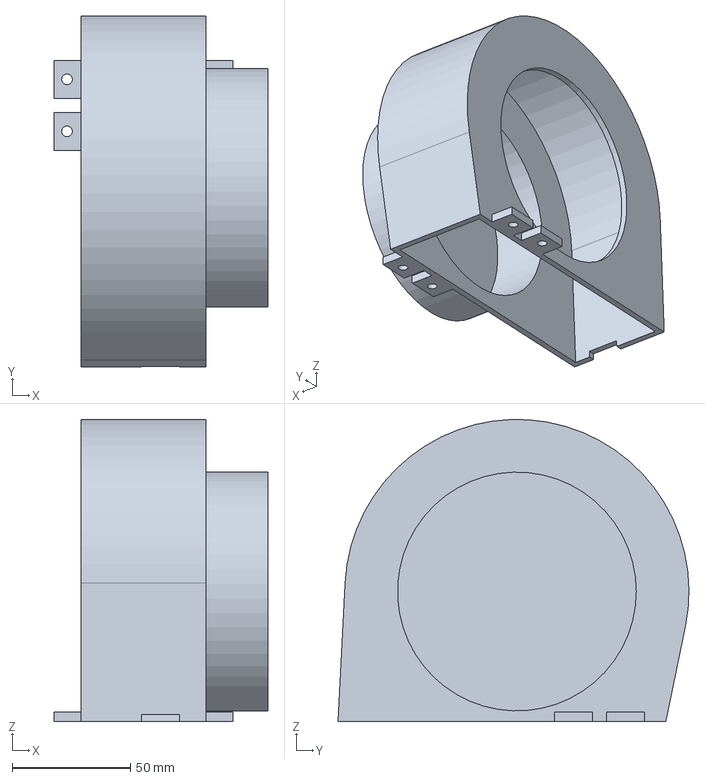
[picture p66: CAD file, 2026-11-12]
cad/step/dg_lower.step
90.5 x 148.5 x 127.8 mm
