liorknafo/plastic-shredder/cad/step/test_lever.step

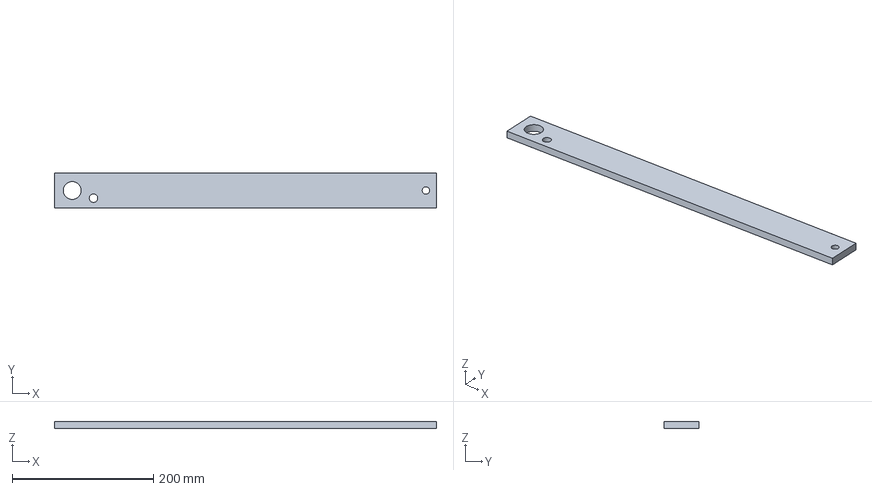
[picture p67: CAD file, 2026-11-12]
cad/step/test_lever.step
540.0 x 50.0 x 10.0 mm
