liorknafo/plastic-shredder/cad/step/tens_base.step

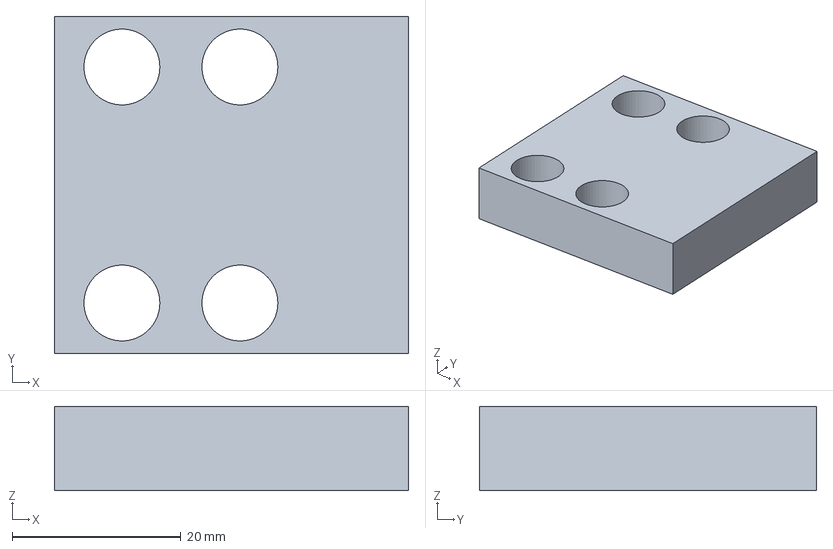
[picture p68: CAD file, 2026-11-12]
cad/step/tens_base.step
42.0 x 40.0 x 10.0 mm
