liorknafo/plastic-shredder/cad/step/free_end_cover.step

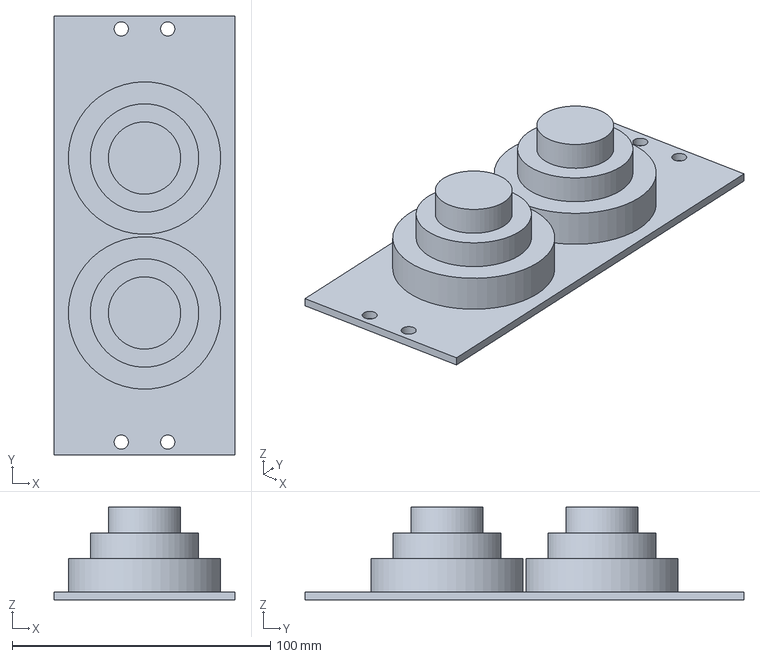
[picture p69: CAD file, 2026-11-12]
cad/step/free_end_cover.step
70.0 x 170.0 x 36.0 mm
