liorknafo/plastic-shredder/cad/step/shaft_B.step

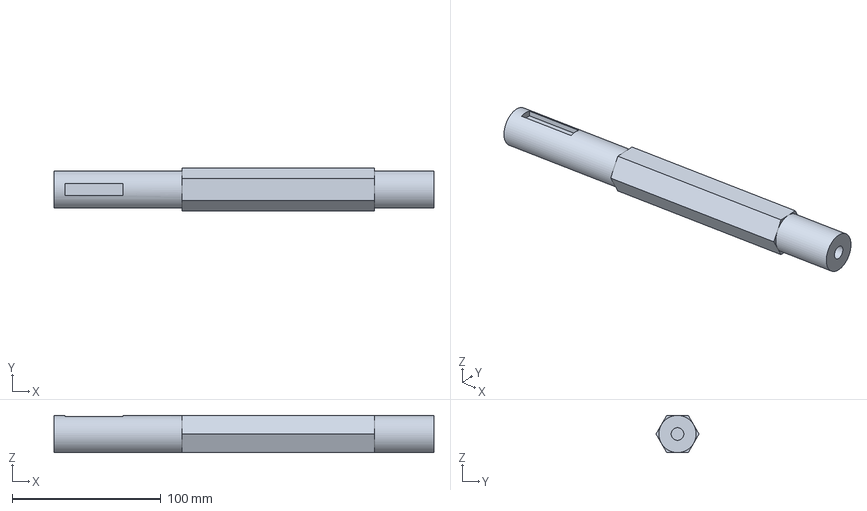
[picture p70: CAD file, 2026-11-12]
cad/step/shaft_B.step
255.2 x 28.9 x 25.1 mm
