liorknafo/plastic-shredder/cad/step/gear_mandrel.step

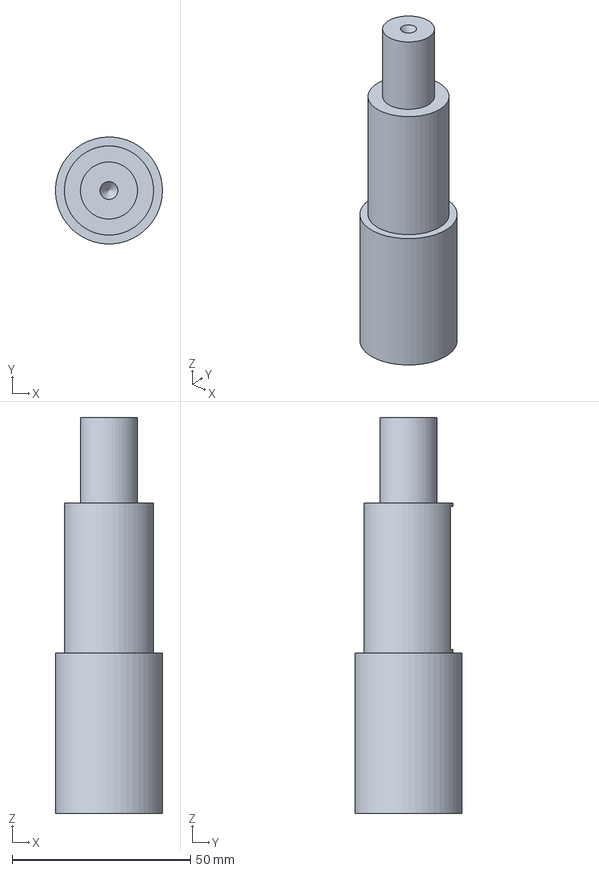
[picture p71: CAD file, 2026-11-12]
cad/step/gear_mandrel.step
30.0 x 30.0 x 111.0 mm
