liorknafo/plastic-shredder/cad/step/base_plate.step

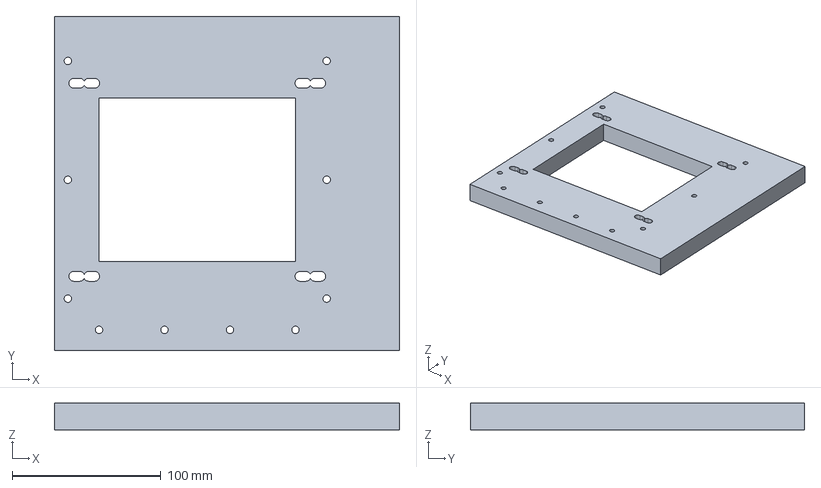
[picture p72: CAD file, 2026-11-12]
cad/step/base_plate.step
232.2 x 225.0 x 18.0 mm
