liorknafo/plastic-shredder/cad/step/leg_angle.step

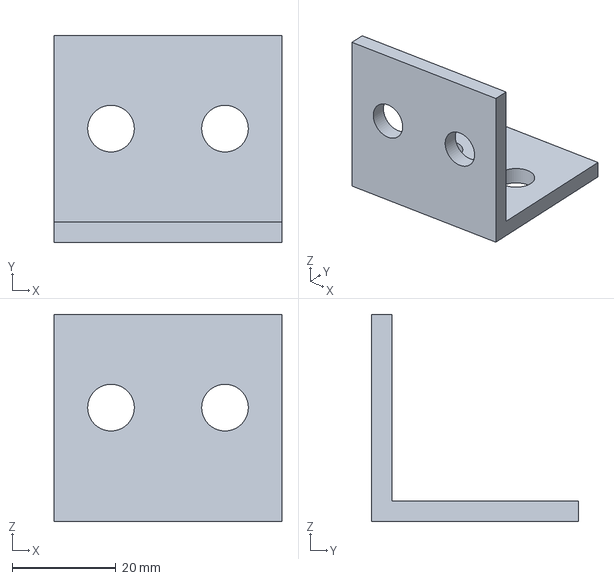
[picture p73: CAD file, 2026-11-12]
cad/step/leg_angle.step
44.0 x 40.0 x 40.0 mm
