liorknafo/plastic-shredder/cad/step/spacer.step

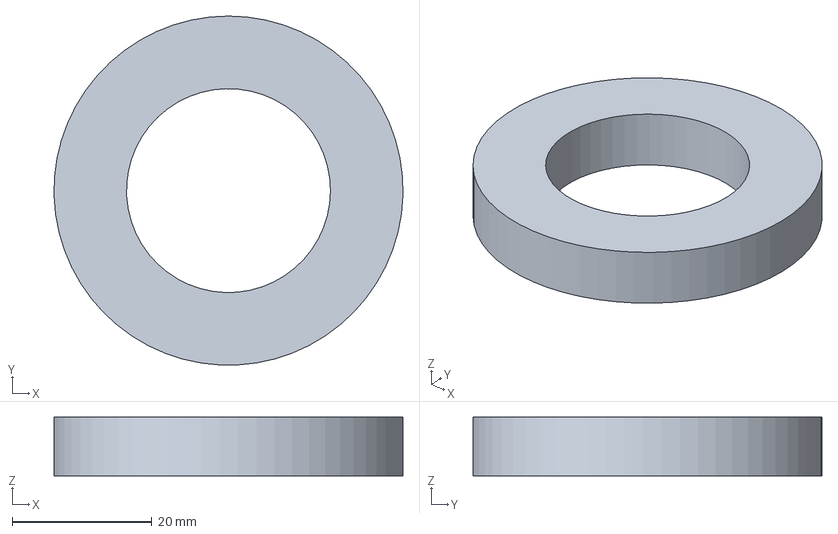
[picture p74: CAD file, 2026-11-12]
cad/step/spacer.step
50.0 x 50.0 x 8.40 mm
