liorknafo/plastic-shredder/cad/params.scad

// GENERATED by design/build.py from design/params.py -- do not edit by hand.

C = 60.0;
N_SLOTS = 16.0;
T_BLADE = 8.0;
SIDE_CLEAR = 0.2;
T_SPACER = 8.4;
END_CLEAR = 0.5;
R_TIP = 34.0;
R_ROOT = 25.0;
TEETH = 3.0;
STAGGER_DEG = 15.0;
BLADE_VARIANTS = 4.0;
SPACER_OD = 50.0;
SPACER_BORE = 29.2;
HEX_AF = 25.05;
HEX_BORE_AF = 25.1;
HEX_RELIEF_D = 3.2;
JOURNAL_D = 25.0;
PLATE_H = 70.0;
PLATE_L = 170.0;
LAYER_T = 10.0;
INNER_HOLE_D = 36.0;
CAP_HOLE_D = 32.0;
SEAL_BORE_DEPTH = 7.0;
CAP_BORE_DEPTH = 7.0;
COLLAR_OD = 46.0;
COLLAR_T = 4.0;
SLEEVE_OD = 30.0;
SLEEVE_ID = 25.05;
COMB_W = 25.0;
COMB_GAP = 0.5;
COMB_SLOT_CLEAR = 0.5;
COMB_SLOT_PAST_TIP = 3.0;
COMB_SCREW_Y = 74.0;
WALL_H = 50.0;
WALL_GAP = 2.0;
END_WASHER_T = 10.0;
END_SCREW_LEN = 30.0;
PRINTER_X = 250.0;
PRINTER_Y = 210.0;
PRINTER_Z = 210.0;
PRINT_WALL = 3.0;
PRINT_FLANGE = 4.0;
HOPPER_TOP_Z = 305.0;
HOPPER_TOP_IN = 180.0;
HOPPER_SPLIT_Z = 105.0;
TOP_HOLE_Y = 10.0;
TOP_HOLE_DEPTH = 10.0;
WALL_TOP_HOLE_X = 30.0;
WALL_TOP_HOLE_Y = 71.0;
SKIRT_HOLE_Y = 77.5;
SKIRT_HOLE_DEPTH = 8.0;
GUARD_HOLE_Y = 80.0;
GUARD_HOLE_Z = 9.0;
GUARD_CLEAR = 3.0;
BASE_T = 18.0;
MOTOR_PULLEY_D = 34.0;
GEARBOX_PULLEY_D = 68.0;
BELT_CENTRE_DIST = 250.0;
BELT_WIDTH = 13.0;
BELT_GUARD_CLEAR = 15.0;
WORM_AXIS_DROP = 63.0;
GROUND_Z = -368.0;
HANDLE_W = 110.0;
HANDLE_H = 40.0;
HANDLE_BACK_T = 8.0;
HANDLE_LIP_D = 26.0;
HANDLE_Z = -250.0;
HANDLE_SCREW_DX = 35.0;
HANDLE_HOLE_D = 4.5;
INSERT_D = 5.6;
INSERT_DEPTH = 6.0;
DRAWER_SW_Z = -300.0;
UFRONT_BELOW = 1.0;
UFRONT_GAP = 1.0;
SW_PAD_L = 92.0;
SW_PAD_W = 32.0;
SW_PAD_T = 10.0;
SW_SCREW_SPACING = 22.0;
INTERLOCK_IN = 12.0;
INTERLOCK_OUT_TRAVEL = 15.0;
BG_LAP_LEN = 16.0;
BG_LAP_CLEAR = 0.3;
BG_FOOT_W = 36.0;
BG_FOOT_T = 4.0;
BG_FOOT_REACH = 16.0;
DECK_PLY_T = 18.0;
DECK_MARGIN = 30.0;
LEG_SECTION = 45.0;
STUB_D = 25.0;
STUB_L = 80.0;
STUB_END_D = 30.0;
STUB_END_L = 60.0;
STUB_FLAT_AF = 22.0;
STUB_FLAT_L = 40.0;
STUB_KEY_L = 70.0;
T_LIMIT = 63.25;
HOOK_DEG = 10.0;
TEST_PIN_D = 12.0;
TEST_PIN_R = 32.0;
TEST_PIN_PROJ = 9.0;
TEST_BLADE_GAP = 1.0;
TEST_LEVER_L = 540.0;
TEST_LEVER_W = 50.0;
TEST_LEVER_T = 10.0;
TEST_LEVER_PIVOT_END = 25.0;
TEST_LEVER_PIVOT_D = 25.2;
TEST_WEIGHT_ARM = 500.0;
TEST_WEIGHT_HOLE_D = 10.5;
TEST_WEIGHT_KG = 11.9;
TEST_BLADE_ROT = -30.0;
TEST_LEVER_DEG = 0.0;
T_SET = 55.0;
T_OPERATING = 45.0;
TL_SET_AT_TL = 110.0;
CHAIN_RATIO = 2.0;
CHAIN_CD = 150.0;
SUBPLATE_T = 20.0;
GB_BOX = [100.0, 100.0, 145.0];
GB_BELOW_OUT = 113.0;
GB_BOSS = 9.0;
GB_FOOT = [124.0, 76.0];
GB_FLANGE = [140.0, 100.0, 8.0];
GB_WORM_STUB = 40.0;
SPROCKET_T = 7.2;
SPROCKET_OD_EXTRA = 6.2;
CHAIN_ENV_W = 18.0;
CHAIN_ENV_H = 12.1;
DRIVE_LEG_MIN = 60.0;
TENS_DELTA = 8.0;
TENS_TRAVEL = 10.0;
TENS_FLAT_W = 50.0;
TENS_T = 10.0;
TENS_BASE = [42.0, 70.0];
TENS_AXLE_D = 10.0;
GUARD_FRONT_X = -70.0;
DG_SEAM_Z = -95.0;
DG_FLANGE_W = 12.0;
DG_FLANGE_T = 4.0;
TLFIX_ARM = 500.0;
TLFIX_LEVER_L = 600.0;
TLFIX_LEVER_W = 50.0;
TLFIX_LEVER_T = 10.0;
TL_HUB_D = 42.0;
TL_FLANGE_T = 8.0;
TL_CM_OFFSET = 12.0;
TL_GB_GAP = 3.0;
TL_PACK_D = 70.0;
TL_PRESS_T = 8.0;
TL_SPRING_L = 26.0;
GB_HUB_L = 72.0;
OUT_SPACER_D = 36.0;
SHAFT_KEY_W = 8.0;
SHAFT_KEY_D = 4.0;
GB_KEY_END = 6.0;
TL_KEY_END = 3.0;
CIRCLIP_GROOVE_D = 23.9;
CIRCLIP_GROOVE_W = 1.3;
CIRCLIP_T = 1.2;
CIRCLIP_OD = 31.4;
CIRCLIP_EDGE = 3.0;
TL_COLLAR_D = 35.0;
TL_COLLAR_T = 5.0;
SHAFT_OUT_END = 3.0;
GB_RAIL_W = 50.0;
GB_RAIL_T = 10.0;
GB_RAIL_SLOT = 6.0;
GB_RAIL_BOLT_DX = 86.0;
GB_RAIL_END = 10.0;
GB_SPACER_L = 18.0;
DECK_RAIL_MARGIN = 20.0;
CHAIN_UPLIFT_LIMIT_N = 2100.0;
CHAIN_UPLIFT_DESIGN_N = 2500.0;
DECK_ANCHOR_D = 8.0;
DECK_ANGLE = [40.0, 40.0, 4.0];
DECK_ANGLE_L = 44.0;
DECK_ANGLE_DECK_BOLTS = 2.0;
DECK_ANGLE_LEG_BOLTS = 2.0;
FOOT_ANGLE_LEG_BOLTS = 2.0;
FOOT_ANGLE_ANCHORS = 2.0;
BIG_WASHER_D = 24.0;
BIG_WASHER_T = 2.0;
DECK_LEG_INSET_Y = 45.0;
TENS_HEAD_H = 40.0;
TENS_COL_GAP = 3.0;
TLFIX_PIN_L = 25.0;
TLFIX_LEVER_GAP = 5.0;
TLFIX_PIVOT_D = 25.2;
TLFIX_LUG = [20.0, 20.0];
TLFIX_LUG_GAP = 2.4;
SW_BODY = [31.0, 30.0, 90.0];
SW_HOLE_SPACING = 22.0;
SW_SLOT = [5.0, 23.0, 20.0];
ACT_SIZE = [12.0, 20.0, 50.0];
ACT_BLADE_T = 3.0;
ACT_BLADE_L = 20.0;
ACT_HOLE_SPACING = 20.0;
PILOT_D = 3.3;
PILOT_DEPTH = 8.0;
HSW_BODY = [42.0, 38.0, 112.0];
HSW_HOLE_SPACING = 22.0;
HSW_SLOT = [6.0, 24.0, 25.0];
HACT_SIZE = [15.0, 20.0, 68.0];
HACT_BLADE_T = 3.0;
HACT_BLADE_L = 22.0;
HACT_HOLE_SPACING = 30.0;
HSW_SCREW = [4.0, 4.5, 7.0, 3.0, 3.3];
HACT_SCREW = [5.0, 5.5, 8.5, 3.5, 4.2];
HSW_PAD_W = 48.0;
DSW_BODY = [30.0, 30.0, 90.0];
DSW_HOLE_SPACING = 22.0;
DSW_SLOT = [5.0, 18.0, 20.0];
DACT_SIZE = [12.0, 15.0, 50.0];
DACT_BLADE_T = 3.0;
DACT_BLADE_L = 20.0;
DACT_HOLE_SPACING = 20.0;
DSW_SCREW = [4.0, 4.5, 7.0, 3.0, 3.3];
DACT_SCREW = [4.0, 4.5, 7.0, 3.0, 3.3];
GRID_PITCH = 25.4;
GRID_WIRE = 2.0;
GRID_Z = -170.0;
GRID_CLEAT = 20.0;
GRID_MIN_DIST = 120.0;
GRID_MAX_OPEN = 30.0;
GRID_EDGE_GAP = 0.5;
GRID_MAX_EDGE_GAP = 10.0;
FINGER_D = 16.0;
GRID_BIN_CLEAR = 4.0;
GRID_SCREW = [4.0, 4.5, 8.0, 3.0, 3.0];
BEARING_name = "NA4905 needle roller bearing with inner ring";
BEARING_d = 25.0;
BEARING_D = 42.0;
BEARING_B = 17.0;
BEARING_F = 30.0;
BEARING_C = 23700.0;
BEARING_C0 = 20500.0;
GEAR_module = 1.5;
GEAR_z = 40.0;
GEAR_alpha = 20.0;
GEAR_bore = 25.0;
GEAR_hub_L = 0.0;
GEAR_cut_extra = 0.1;
GEAR_LAYER_T = 9.8;
GEAR_LAYERS = 4.0;
GEAR_SPACER_D = 36.0;
GEAR_ROUGH_D = 64.0;
GEAR_KEY_W = 8.0;
GEAR_KEYWAY_H = 3.3;
GEAR_KEY_TOOL_D = 3.0;
GEAR_KEY_CHAMFER = 1.5;
SEAL_d = 30.0;
SEAL_D = 42.0;
SEAL_B = 7.0;
THRUST_d = 30.0;
THRUST_D = 47.0;
THRUST_T = 4.0;
CRINKLE_d = 30.0;
CRINKLE_D = 39.0;
CRINKLE_n = 3.0;
CRINKLE_stack_h = 2.0;
SPROCKET_A_z = 15.0;
SPROCKET_A_hub_L = 22.4;
SPROCKET_A_hub_D = 39.0;
TL_z = 30.0;
TL_L = 62.0;
TL_D = 89.0;
TL_T_min = 34.0;
TL_T_max = 149.0;
CHAIN_pitch = 12.7;
DECK_ANCHOR = "M8";
IDLER_NAME = "#40 15T idler sprocket with bearing, M10/12 bore (bought)";

// derived
blades_per_shaft = 8.0;
stack_A = 131.2;
end_spacer_B = 8.2;
stack_B = 131.0;
chamber_L = 132.2;
overlap = 8.0;
tip_to_spacer = 1.0;
hex_AC = 28.9252;
bore_AC = 28.983;
bearing_x_drive = -18.5;
bearing_x_free = 150.7;
bearing_span = 169.2;
sleeve_L_drive = 10.5;
sleeve_L_free_A = 10.5;
sleeve_L_free_B = 10.7;
x_inner_ring_out_drive = -27.0;
x_cap_out_drive = -30.0;
collar_body_L_drive = 7.0;
x_collar_in_drive = -34.0;
x_collar_out_drive = -38.0;
gear_face = 39.2;
x_gear_in = -38.0;
x_gear_out = -77.2;
gear_spacer_L = 8.8;
x_gear_hub_out = -86.0;
x_sprocket_in = -86.0;
x_sprocket_out = -108.4;
x_sprocket_c = -97.2;
x_chain = -104.8;
x_inner_ring_out_free = 159.2;
x_cap_out_free = 162.2;
collar_body_L_free = 9.0;
x_collar_in_free = 168.2;
x_collar_out_free = 172.2;
shaft_end_free = 170.7;
shaft_end_A_drive = -106.9;
shaft_end_B_drive = -84.5;
shaft_A_len = 277.6;
shaft_B_len = 255.2;
sprocket_A_pd = 61.0836;
tl_sprocket_pd = 121.498;
hex_x0 = 1.5;
hex_x1 = 130.7;
gear_pitch_d = 60.0;
gear_od = 63.0;
gear_root_d_std = 56.25;
gear_root_d = 56.05;
gear_cut_depth = 3.475;
comb_edge_y = 55.5;
comb_slot_w = 9.0;
comb_slot_bottom_y = 67.0;
wall_inner_y = 66.0;

// blade torque test lever: computed from the blade outline (design/build.py, test_lever_numbers)
test_pin_Rmin = 30.9995;
test_pin_s = 1.4836;
test_pin_psi = 10.1718;
test_pin_contact_r = 32.54;
test_pin_clear = 0.1807;
hook_face_len = 4.546;
hook_face_end_r = 29.5336;
test_pin_off = -10.8544;
test_pin_edge_steel = 8.1456;
test_pin_ring_steel = 13.4;
test_pin_F = 1976.5625;
test_pin_sigma = 58.2555;
test_pin_deg = -19.8282;
test_face_nrm_deg = 70.0;
