liorknafo/plastic-shredder/cad/blade_profile.scad

// GENERATED by design/build.py -- blade outline and hex bores (mm).
// blade_outline(): CCW polygon, tooth tips at 0/120/240 deg, blade turns CCW (+angle).
// blade_hex(v): hex bore vertices for phase variant v (vertex at v*STAGGER_DEG).

blade_outline_pts = [[0.8725,-24.9848], [1.3099,-24.9941], [1.7488,-25.0088], [2.1892,-25.0227], [2.6312,-25.0340], [3.0747,-25.0417], [3.5199,-25.0451], [3.9665,-25.0437], [4.4147,-25.0371], [4.8644,-25.0250], [5.3154,-25.0071], [5.7678,-24.9833], [6.2215,-24.9532], [6.6764,-24.9168], [7.1325,-24.8739], [7.5895,-24.8242], [8.0475,-24.7678], [8.5064,-24.7044], [8.9660,-24.6339], [9.4263,-24.5563], [9.8871,-24.4714], [10.3483,-24.3791], [10.8098,-24.2793], [11.2716,-24.1720], [11.7334,-24.0570], [12.1951,-23.9343], [12.6567,-23.8038], [13.1180,-23.6655], [13.5788,-23.5192], [14.0391,-23.3650], [14.4987,-23.2027], [14.9574,-23.0323], [15.4151,-22.8538], [15.8717,-22.6671], [16.3270,-22.4722], [16.7809,-22.2690], [17.2332,-22.0575], [17.6838,-21.8377], [18.1325,-21.6095], [18.5792,-21.3729], [19.0237,-21.1280], [19.4659,-20.8746], [19.9055,-20.6128], [20.3425,-20.3425], [20.7767,-20.0638], [21.2079,-19.7767], [21.6359,-19.4811], [22.0606,-19.1770], [22.4819,-18.8646], [22.8995,-18.5437], [23.3133,-18.2144], [23.7231,-17.8767], [24.1288,-17.5306], [24.5302,-17.1762], [24.9271,-16.8135], [25.3193,-16.4425], [25.7067,-16.0633], [26.0891,-15.6759], [26.4664,-15.2804], [26.8384,-14.8767], [27.2048,-14.4650], [27.5656,-14.0454], [27.9205,-13.6177], [28.2694,-13.1823], [28.6122,-12.7390], [28.9486,-12.2880], [29.2785,-11.8293], [29.6017,-11.3630], [29.9181,-10.8893], [30.2275,-10.4082], [30.5297,-9.9197], [30.8245,-9.4240], [31.1119,-8.9212], [31.3916,-8.4113], [31.6634,-7.8946], [31.9273,-7.3710], [32.1830,-6.8407], [32.4304,-6.3038], [32.6694,-5.7605], [32.8998,-5.2108], [33.1214,-4.6549], [33.3341,-4.0929], [33.5377,-3.5250], [33.7321,-2.9512], [33.9172,-2.3717], [33.9632,-1.5819], [33.9908,-0.7911], [34.0000,0.0000], [29.5230,-0.7894], [29.0900,-0.8416], [28.6538,-0.8464], [28.2197,-0.8036], [27.7929,-0.7138], [27.3784,-0.5781], [26.9811,-0.3980], [26.6058,-0.1758], [26.2569,0.0860], [25.9386,0.3842], [25.6546,0.7153], [25.4084,1.0754], [25.2029,1.4601], [25.0404,1.8649], [24.9230,2.2850], [24.8521,2.7154], [24.7992,3.1619], [24.7384,3.6074], [24.6695,4.0518], [24.5926,4.4949], [24.5078,4.9365], [24.4150,5.3765], [24.3144,5.8147], [24.2059,6.2511], [24.0895,6.6855], [23.9654,7.1176], [23.8335,7.5475], [23.6939,7.9750], [23.5466,8.3999], [23.3917,8.8220], [23.2293,9.2413], [23.0593,9.6576], [22.8818,10.0708], [22.6970,10.4807], [22.5048,10.8873], [22.3054,11.2903], [22.0987,11.6896], [21.8849,12.0852], [21.6640,12.4769], [21.4361,12.8645], [21.2012,13.2480], [20.9905,13.6314], [20.7838,14.0189], [20.5757,14.4073], [20.3645,14.7957], [20.1494,15.1837], [19.9298,15.5709], [19.7052,15.9570], [19.4754,16.3418], [19.2401,16.7252], [18.9991,17.1069], [18.7522,17.4867], [18.4994,17.8646], [18.2404,18.2404], [17.9752,18.6138], [17.7037,18.9849], [17.4258,19.3533], [17.1414,19.7190], [16.8506,20.0818], [16.5532,20.4415], [16.2493,20.7981], [15.9387,21.1514], [15.6216,21.5012], [15.2977,21.8474], [14.9673,22.1899], [14.6301,22.5284], [14.2864,22.8630], [13.9359,23.1933], [13.5788,23.5192], [13.2151,23.8407], [12.8448,24.1576], [12.4679,24.4696], [12.0844,24.7768], [11.6945,25.0789], [11.2980,25.3757], [10.8951,25.6672], [10.4858,25.9532], [10.0701,26.2335], [9.6481,26.5080], [9.2199,26.7765], [8.7855,27.0390], [8.3450,27.2952], [7.8984,27.5451], [7.4459,27.7884], [6.9874,28.0251], [6.5232,28.2549], [6.0531,28.4778], [5.5775,28.6936], [5.0962,28.9022], [4.6095,29.1034], [4.1174,29.2971], [3.6201,29.4832], [3.1175,29.6615], [2.6099,29.8319], [2.0974,29.9942], [1.5800,30.1484], [1.0579,30.2943], [0.5312,30.4318], [0.0000,30.5608], [-0.5355,30.6811], [-1.0753,30.7926], [-1.6191,30.8952], [-2.1669,30.9887], [-2.7186,31.0732], [-3.2738,31.1484], [-3.8326,31.2142], [-4.3948,31.2706], [-4.9602,31.3174], [-5.5286,31.3545], [-6.1000,31.3818], [-6.6741,31.3993], [-7.2508,31.4068], [-7.8300,31.4043], [-8.4113,31.3916], [-8.9948,31.3686], [-9.5802,31.3353], [-10.1673,31.2917], [-10.7559,31.2375], [-11.3460,31.1728], [-11.9372,31.0975], [-12.5294,31.0114], [-13.1225,30.9146], [-13.7161,30.8070], [-14.3103,30.6885], [-14.9046,30.5590], [-15.6117,30.2039], [-16.3102,29.8325], [-17.0000,29.4449], [-14.0779,25.9624], [-13.8161,25.6135], [-13.5939,25.2381], [-13.4139,24.8408], [-13.2783,24.4263], [-13.1885,23.9994], [-13.1458,23.5653], [-13.1506,23.1292], [-13.2029,22.6961], [-13.3020,22.2713], [-13.4468,21.8599], [-13.6355,21.4666], [-13.8659,21.0963], [-14.1353,20.7532], [-14.4404,20.4415], [-14.7776,20.1649], [-15.1379,19.8958], [-15.4933,19.6203], [-15.8437,19.3385], [-16.1890,19.0504], [-16.5290,18.7561], [-16.8637,18.4558], [-17.1929,18.1495], [-17.5165,17.8373], [-17.8345,17.5194], [-18.1468,17.1958], [-18.4531,16.8666], [-18.7535,16.5320], [-19.0478,16.1920], [-19.3359,15.8468], [-19.6178,15.4965], [-19.8934,15.1411], [-20.1625,14.7809], [-20.4251,14.4158], [-20.6811,14.0461], [-20.9304,13.6719], [-21.1729,13.2932], [-21.4085,12.9102], [-21.6373,12.5231], [-21.8590,12.1319], [-22.0737,11.7368], [-22.3004,11.3626], [-22.5326,10.9899], [-22.7649,10.6154], [-22.9957,10.2383], [-23.2241,9.8581], [-23.4496,9.4743], [-23.6718,9.0867], [-23.8901,8.6953], [-24.1045,8.2998], [-24.3145,7.9003], [-24.5201,7.4965], [-24.7209,7.0886], [-24.9168,6.6764], [-25.1076,6.2600], [-25.2932,5.8394], [-25.4733,5.4145], [-25.6478,4.9854], [-25.8166,4.5522], [-25.9795,4.1147], [-26.1364,3.6732], [-26.2870,3.2276], [-26.4314,2.7781], [-26.5693,2.3245], [-26.7007,1.8671], [-26.8253,1.4059], [-26.9431,0.9409], [-27.0539,0.4722], [-27.1577,0.0000], [-27.2542,-0.4757], [-27.3435,-0.9549], [-27.4253,-1.4373], [-27.4995,-1.9230], [-27.5662,-2.4117], [-27.6250,-2.9035], [-27.6760,-3.3982], [-27.7190,-3.8956], [-27.7539,-4.3958], [-27.7806,-4.8985], [-27.7991,-5.4036], [-27.8092,-5.9110], [-27.8109,-6.4206], [-27.8040,-6.9323], [-27.7884,-7.4459], [-27.7641,-7.9612], [-27.7310,-8.4782], [-27.6891,-8.9967], [-27.6381,-9.5166], [-27.5781,-10.0376], [-27.5090,-10.5597], [-27.4307,-11.0827], [-27.3432,-11.6065], [-27.2464,-12.1309], [-27.1401,-12.6556], [-27.0245,-13.1807], [-26.8993,-13.7059], [-26.7646,-14.2310], [-26.6203,-14.7559], [-26.4664,-15.2804], [-26.3028,-15.8043], [-26.1295,-16.3275], [-25.9464,-16.8498], [-25.7536,-17.3710], [-25.5509,-17.8909], [-25.3384,-18.4094], [-25.1160,-18.9263], [-24.8837,-19.4413], [-24.6415,-19.9543], [-24.3895,-20.4652], [-24.1275,-20.9737], [-23.8555,-21.4796], [-23.5737,-21.9828], [-23.2819,-22.4831], [-22.9802,-22.9802], [-22.6686,-23.4740], [-22.3471,-23.9643], [-22.0157,-24.4510], [-21.6745,-24.9337], [-21.3234,-25.4123], [-20.9626,-25.8866], [-20.5920,-26.3565], [-20.2116,-26.8217], [-19.8215,-27.2820], [-19.4219,-27.7373], [-19.0126,-28.1873], [-18.3515,-28.6220], [-17.6805,-29.0413], [-17.0000,-29.4449], [-15.4452,-25.1730], [-15.2739,-24.7719], [-15.0599,-24.3918], [-14.8058,-24.0372], [-14.5146,-23.7124], [-14.1898,-23.4213], [-13.8352,-23.1673], [-13.4551,-22.9534], [-13.0540,-22.7821], [-12.6365,-22.6556], [-12.2078,-22.5752], [-11.7729,-22.5420], [-11.3370,-22.5564], [-10.9052,-22.6181], [-10.4827,-22.7265], [-10.0745,-22.8802], [-9.6613,-23.0577], [-9.2450,-23.2278], [-8.8258,-23.3903], [-8.4036,-23.5453], [-7.9788,-23.6926], [-7.5514,-23.8323], [-7.1215,-23.9642], [-6.6893,-24.0884], [-6.2550,-24.2049], [-5.8186,-24.3134], [-5.3804,-24.4142], [-4.9404,-24.5070], [-4.4988,-24.5919], [-4.0558,-24.6688], [-3.6114,-24.7378], [-3.1659,-24.7987], [-2.7194,-24.8517], [-2.2719,-24.8966], [-1.8238,-24.9334], [-1.3750,-24.9622], [-0.9258,-24.9829], [-0.4763,-24.9955], [-0.0267,-25.0000], [0.4230,-24.9964]];
blade_hex_0 = [[14.4915,0.0000], [7.2457,12.5500], [-7.2457,12.5500], [-14.4915,0.0000], [-7.2457,-12.5500], [7.2457,-12.5500]];
blade_hex_1 = [[13.9977,3.7507], [3.7507,13.9977], [-10.2470,10.2470], [-13.9977,-3.7507], [-3.7507,-13.9977], [10.2470,-10.2470]];
blade_hex_2 = [[12.5500,7.2457], [0.0000,14.4915], [-12.5500,7.2457], [-12.5500,-7.2457], [-0.0000,-14.4915], [12.5500,-7.2457]];
blade_hex_3 = [[10.2470,10.2470], [-3.7507,13.9977], [-13.9977,3.7507], [-10.2470,-10.2470], [3.7507,-13.9977], [13.9977,-3.7507]];
function blade_hex(v) = v == 0 ? blade_hex_0 : v == 1 ? blade_hex_1 : v == 2 ? blade_hex_2 : blade_hex_3;
