liorknafo/plastic-shredder/(list of files, cad)

Other CAD files:
cad/step/comb_B.step
cad/step/sleeve_drive.step
cad/step/skirt_B.step
cad/step/gear_A.step
cad/plate.scad
cad/previews.scad
cad/shaft.scad
cad/sleeve.scad
cad/smallparts.scad
cad/spacer.scad
cad/stack.scad
cad/testlever.scad
cad/tl350.scad
cad/tlfix.scad
cad/wall.scad
cad/dxf/base_plate.dxf
cad/dxf/blade_v0.dxf
cad/dxf/blade_v1.dxf
cad/dxf/blade_v2.dxf
cad/dxf/blade_v3.dxf
cad/dxf/comb_A.dxf
cad/dxf/drive_deck.dxf
cad/dxf/gb_rail.dxf
cad/dxf/gear_layer.dxf
cad/dxf/grid_cleats.dxf
cad/dxf/grid_mesh.dxf
cad/dxf/output_shaft.dxf
cad/dxf/tens_base.dxf
cad/dxf/tens_upright.dxf
cad/dxf/test_lever.dxf
cad/dxf/tl_lever.dxf
cad/dxf/tl_stub.dxf
cad/step/blade_v0.step
cad/step/blade_v1.step
cad/step/blade_v2.step
cad/stl/base_plate.stl
cad/stl/belt_guard_a.stl
cad/stl/belt_guard_b.stl
cad/stl/blade_v0.stl
cad/stl/blade_v1.stl
cad/stl/blade_v2.stl
cad/stl/blade_v3.stl
cad/stl/cabinet.stl
cad/stl/collar_sleeve_drive.stl
cad/stl/collar_sleeve_free.stl
cad/stl/comb_A.stl
cad/stl/comb_B.stl
cad/stl/dg_lower.stl
cad/stl/dg_upper.stl
cad/stl/drawer_act_pad.stl
cad/stl/drawer_handle.stl
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
