liorknafo/plastic-shredder/cad/png/assembly_front.png

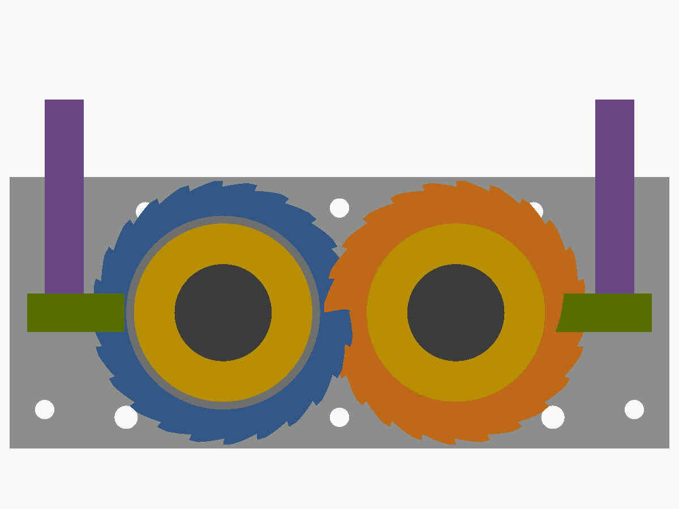
cad/png/assembly_front.png
