liorknafo/plastic-shredder/cad/png/assembly_guards.png

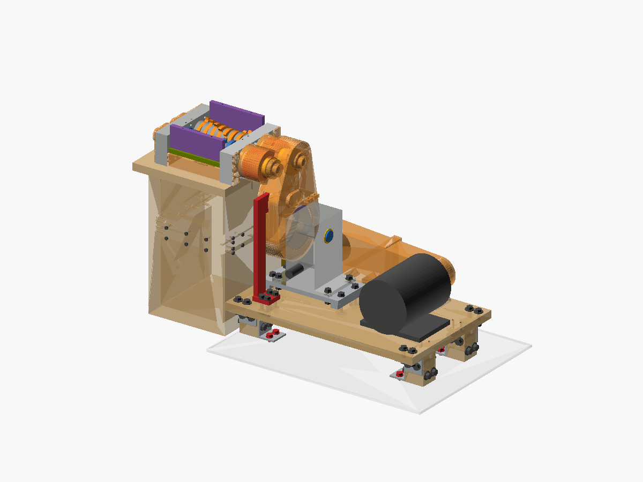
cad/png/assembly_guards.png
