liorknafo/plastic-shredder/cad/png/assembly_top.png

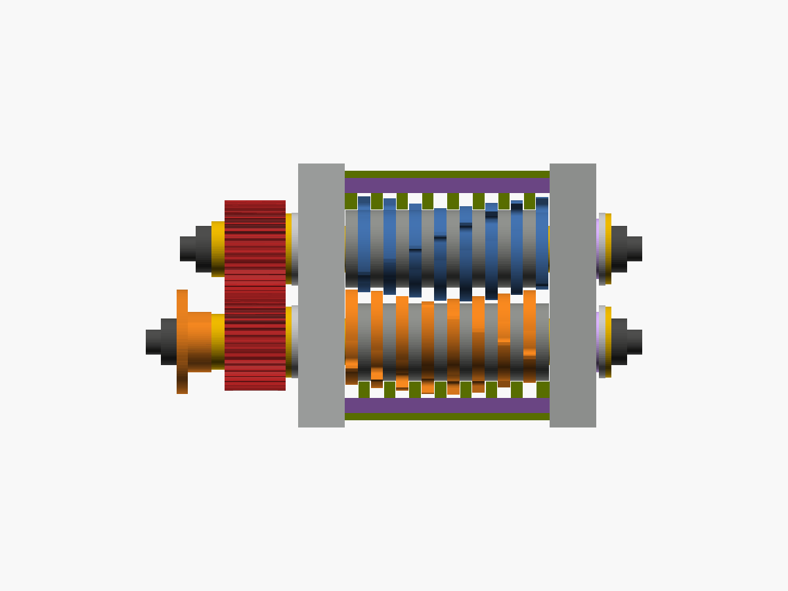
cad/png/assembly_top.png
