liorknafo/plastic-shredder/cad/png/blade_torque_test.png

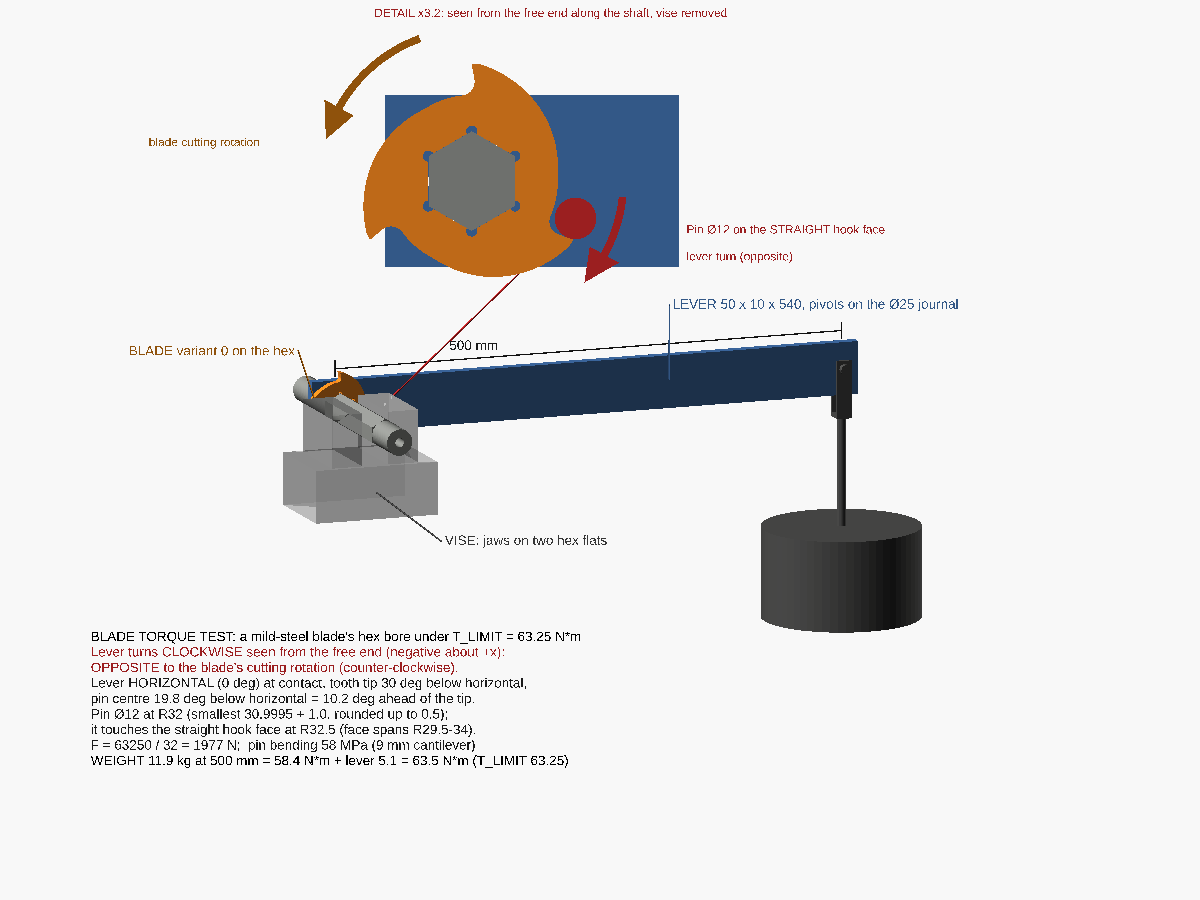
cad/png/blade_torque_test.png
