liorknafo/plastic-shredder/(commit log)

2026-11-08 Twin-shaft plastic shredder design
    Parametric OpenSCAD + Python design: blades, hex shafts (4140), NA4905 needle
    bearings, home-made M1.5 laminated gears, NRV063 worm gearbox with TL350 torque
    limiter and #40 chain drive, guarded hopper with guard-locking lid, cabinet with
    fixed front panel, safety grid and interlocked drawer. Calculations
    (calc/calc.py -> docs/CALCULATIONS.md), interference checks (cad/build.sh,
    cad/variants.sh), build guide (docs/DESIGN.md) and a SolidCraft assembly.
    [assembly.scad, axes.scad, base.scad, base_plate.dxf, base_plate.stl, belt_guard_a.stl, belt_guard_b.stl, blade.scad]
2026-11-12 Convert the CAD model to a native SolidCraft project
    cad/shredder_assembly.sc is now native SolidCraft 0.40 geometry instead of
    imported OpenSCAD meshes: 8 components, 382 bodies (one per part), 7 joints,
    4 motion links and 3 motion studies, built from design/params.py by
    cad/solidcraft (build.py, model/*.py, scq.py).
    - model/*.py: one module per cad/*.scad file, translated function for function
    - parts.py: every made part from SolidCraft to cad/step (new), cad/stl and
    cad/dxf (outlines with true arcs)
    - check.py, reference.json, parts_reference.json: every group of bodies and
    every part against the measurements of the old OpenSCAD model
    - interference.py: SolidCraft's exact interferenc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
    [axes.scad, base_plate.dxf, base_plate.step, base_plate.stl, belt_guard_a.step, belt_guard_a.stl, belt_guard_b.step, belt_guard_b.stl]
